eSpark-Backup/fredmeiring-trailersockettester/Hardware-Designing/Deliverables/Renderings/3D_Top.png

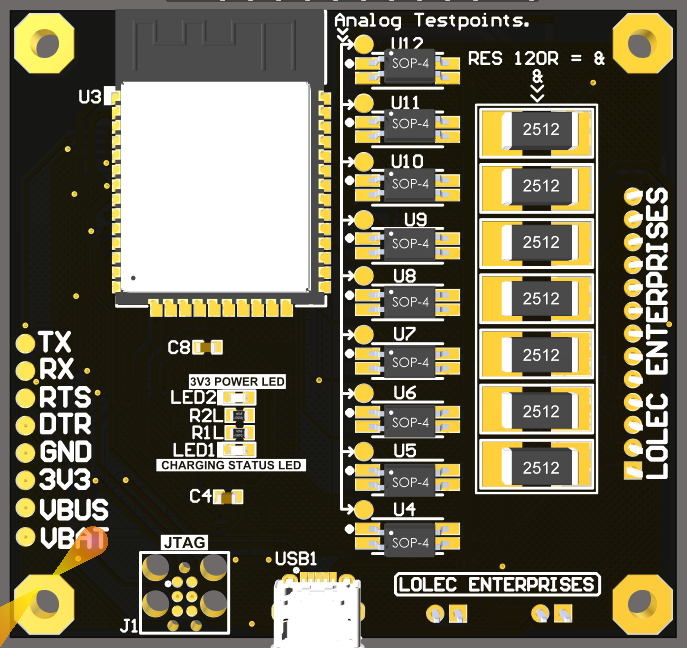
Hardware-Designing/Deliverables/Renderings/3D_Top.png
