eSpark-Backup/fredmeiring-trailersockettester/Hardware-Designing/Deliverables/Renderings/3D_Bottom.png

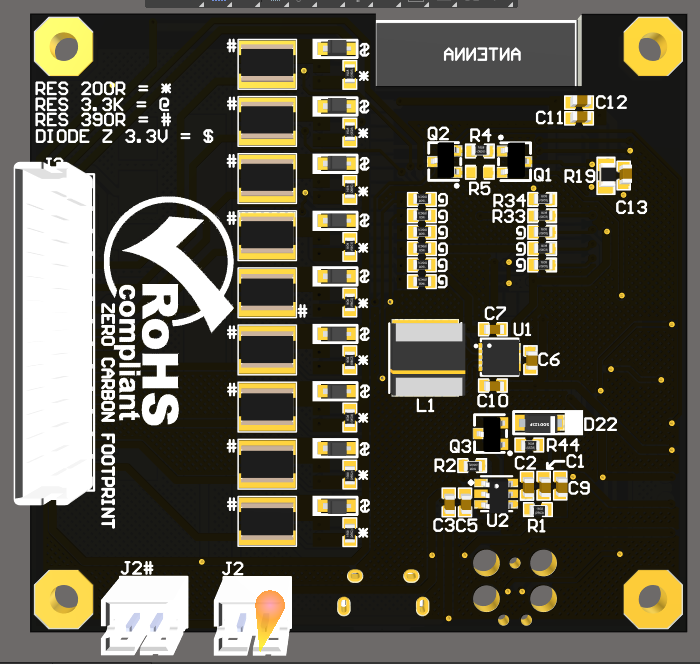
Hardware-Designing/Deliverables/Renderings/3D_Bottom.png
