eSpark-Backup/fredmeiring-trailersockettester/README.md

# FredMeiring-TrailerSocketTester
To design the hardware of a Trailer Socket Tester that can safely read 12V indications from a Trailer and display them in an Android App.
