eSpark-Backup/fredmeiring-trailersockettester/Hardware-Designing/Design-Files/Fred_ New.PcbDoc.htm

Reporting Options

# File in Previous Format

Date | : | 7/24/2023
Time | : | 12:37:49 PM
Filename | : | D:\eSpark-Consultants\FredMeiring-TrailerSocketTester\Hardware-Designing\Design-Files\Fred_ New.PcbDoc

Version | Warning

This file was generated by an earlier version of the software
