eSpark-Backup/fredmeiring-trailersockettester/Hardware-Designing/Deliverables/Renderings/2D_Top.png

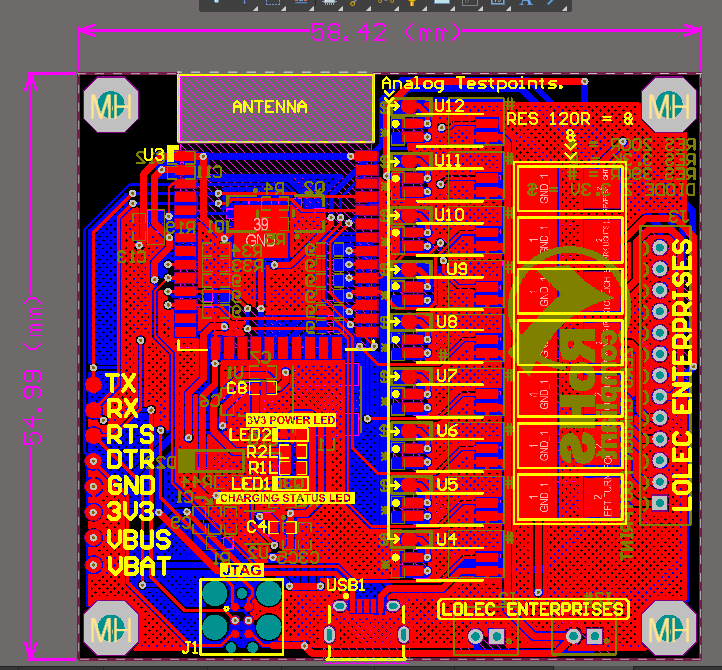
Hardware-Designing/Deliverables/Renderings/2D_Top.png
