eSpark-Backup/fredmeiring-trailersockettester/Hardware-Designing/Deliverables/Renderings/3D_Isometric.png

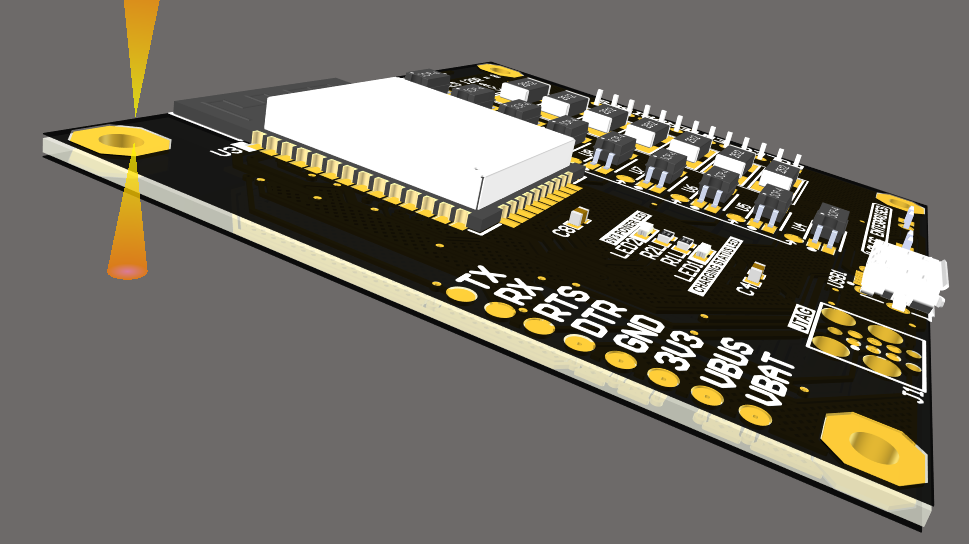
Hardware-Designing/Deliverables/Renderings/3D_Isometric.png
