eSpark-Backup/fredmeiring-trailersockettester/Firmware-Development/Testing-Firmware/Components List/BOM.xlsx

Bill Of Materials
S.No | Materials | Part Number | Package | Value | Description | Reference URL | Quantity | Unit Price | Total Price
1 | ESP32 Module | ESP32-WROOM-32 | SoC IC | - | SMD MODULE, ESP32-D0WDQ6, 32MBIT with onBoard Flash, Crystal Oscillator, Antenna | https://www.digikey.com/product-detail/en/espressif-systems/ESP32-WROOM-32/1904-1010-1-ND/8544305 | 1 | $6.80 | $6.80
2 | LDO Linear Volt Regulator | ADM7172ACPZ-R7 | 8-lead, 3 mm × 3 mm LFCSP package | - | Linear Voltage Regulator IC Positive Adjustable Output 1.2 V - 6.328 V, 2A | https://www.digikey.com/product-detail/en/analog-devices-inc/ADM7172ACPZ-R7/ADM7172ACPZ-R7CT-ND/5004752 | 1 | $4.89 | $4.89
3 | Battery Charging IC | MCP73831T-2ACI/MC | 5-Lead, SOT-23 package | - | Lithium Li-ion/Polymer Battery Charging IC | https://www.digikey.com/product-detail/en/microchip-technology/MCP73831T-2ACI-MC/MCP73831T-2ACI-MCCT-ND/7065590 | 1 | $0.61 | $0.61
4 | Fuel Guage IC | BQ27621YZFR-G1A | 9-pin, 1.62 × 1.58 mm, 0.5 mm pitch YZF package | - | Battery Monitor IC Lithium-Ion 9-DSBGA | https://www.digikey.com/product-detail/en/texas-instruments/BQ27621YZFR-G1A/296-37460-1-ND/4759540 | 1 | $2.27 | $2.27
5 | 6-Axis Accelero/Gyro | ICM-20689 | 24-pin, 4x4x0.9 mm QFN package | - | Accelerometer, Gyroscope, Temperature, 6 Axis Sensor I²C, SPI Output IC | https://www.digikey.com/product-detail/en/tdk-invensense/ICM-20689/1428-1059-1-ND/5872874 | 1 | $6.99 | $6.99
6 | Ceramic CutTape Cap | GCM21BR71H474KA55L | 0805 Package | 0.47uF | 0.47µF ±10% 50V Ceramic Capacitor X7R 0805 (2012 Metric) | https://www.digikey.com/product-detail/en/murata-electronics-north-america/GCM21BR71H474KA55L/490-4788-1-ND/1641707 | 2 | $0.39 | $0.78
7 | Ceramic CutTape Cap | GRM21BR61H475KE51L | 0805 Package | 4.7uF | 4.7µF ±10% 50V Ceramic Capacitor X5R 0805 (2012 Metric) | https://www.digikey.com/product-detail/en/murata-electronics-north-america/GRM21BR61H475KE51L/490-10751-1-ND/5251349 | 4 | $0.40 | $1.60
8 | Ceramic CutTape Cap | GCJ21AR72E102KXJ1D | 0805 Package | 1000pF | 1000pF ±10% 250V Ceramic Capacitor X7R 0805 (2012 Metric) | https://www.digikey.com/product-detail/en/murata-electronics-north-america/GCJ21AR72E102KXJ1D/490-5589-1-ND/2380343 | 1 | $0.28 | $0.28
9 | Ceramic CutTape Cap | GCM21BR71H104KA37K | 0805 Package | 0.1uF | 0.1µF ±10% 50V Ceramic Capacitor X7R 0805 (2012 Metric) | https://www.digikey.com/product-detail/en/murata-electronics-north-america/GCM21BR71H104KA37K/490-8049-1-ND/4380334 | 1 | $0.23 | $0.23
10 | Ceramic CutTape Cap | GCM219R71C105KA37D | 0805 Package | 1uF | 1µF ±10% 16V Ceramic Capacitor X7R 0805 (2012 Metric) | https://www.digikey.com/product-detail/en/murata-electronics-north-america/GCM219R71C105KA37D/490-8043-1-ND/4380328 | 1 | $0.27 | $0.27
11 |  |  |  |  |  |  |  |  | $0.00
12 |  |  |  |  |  |  |  |  | $0.00
13 |  |  |  |  |  |  |  |  | $0.00
14 |  |  |  |  |  |  |  |  | $0.00
15 |  |  |  |  |  |  |  |  | $0.00
16 |  |  |  |  |  |  |  |  | $0.00
17 |  |  |  |  |  |  |  |  | $0.00
