eSpark-Backup/fredmeiring-trailersockettester/Firmware-Development/Testing-Firmware/Components List/Component_List.xlsx

Power Section
S.No | Item Name | Description | Reference Link | Price
1 | ADM7172 | LDO Regulator | www.analog.com/media/en/technical-documentation/data-sheets/adm7172.pdf | -
2 | BQ27621 | Fuel Guage IC | www.ti.com/lit/ds/symlink/bq27621-g1.pdf | -
3 | MCP73831 | Battery Charging IC | https://www.microchip.com/mcp73831 | -
4
5
Controlling Section
S.No | Item Name | Description | Reference Link | Price
1 | ESP32 Module | Main Controller | https://www.espressif.com/zh-hans/products/hardware/esp-wroom-32/overview | -
2
Peripherals (Buttons, Sensors etc)
S.No | Item Name | Description | Reference Link | Price
1 | ICM20689 | 6-Axis Acc/Gyro | https://www.invensense.com/download-pdf/icm-20689-datasheet/ | -
2 | Tactile Switch | 8mm Soft Tactile Buttons | https://www.adafruit.com/product/3101 | -
3 | B3F-1000 | 12mm Hard Tactile Buttons | https://www.adafruit.com/product/367 | -
4
