eSpark-Backup/fredmeiring-trailersockettester/Hardware-Designing/Deliverables/BOM/BOM-FRED_MIERING - DIGIKEY.xlsx

Bill Of Material (BOM) for FRED MEIRING
S. No. | CommentType | Description | Designator | Footprint (Package) | Manufacturer Part Number | Manufacturer | Value | Quantity | Total Quantity | Link | Unit Price | Total Price | Remarks
1 | Capacitor | Capacitor Ceramic 0.1UF 50V Y5V 0603 | C1, C4, C5, C6, C8, C10, C11, C12, C13 | 0603 (1608 Metric) | CC0603ZRY5V9BB104 | Yageo | 0.1uF | 9 | 47 | Digikey (https://www.digikey.com/product-detail/en/avx-corporation/0402ZD104KAT2A/478-1129-1-ND/564161) | $0.10 | $4.70
2 |  | Capacitor Ceramic 1UF 50V X7R 0603 | C9 | 0603 (1608 Metric) | UMK107AB7105KA-T | Taiyo Yuden | 1uF | 1 | 7 | Digikey (https://www.digikey.com/product-detail/en/taiyo-yuden/UMK107AB7105KA-T/587-3247-1-ND/3660107) | $0.25 | $1.75
3 |  | Capacitor Ceramic 4.7UF 25V X5R 0603 | C2 | 0603 (1608 Metric) | GRM188R61E475KE11D | Murata | 4.7uF | 1 | 7 | Digikey (https://www.digikey.com/products/en/capacitors/ceramic-capacitors/60?k=GRM188R61E475KE11D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) | $0.41 | $2.87
4 |  | Capacitor Ceramic 10UF 25V X5R 0603 | C3, C7 | 0603 (1608 Metric) | C1608X5R1E106M080AC | TDK | 10uF | 2 | 12 | Digikey (https://www.digikey.com/products/en/capacitors/ceramic-capacitors/60?k=C1608X5R1E106M080AC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) | $0.84 | $10.08
5 | Transistor | Transistor NPN 40V 0.6A SMD SOT23-3 | Q1, Q2 | SOT23-3 | MMBT2222A-7-F | Diodes Incorporated | --- | 2 | 12 | Digikey (https://www.digikey.com/products/en/discrete-semiconductor-products/transistors-bipolar-bjt-single/276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) | $0.13 | $1.56
6 |  | MOSFET P-Channel 24V SOT23 | Q3 | SOT23-3 | DMP2045U-7 | Diodes Incorporated | --- | 1 | 6 | Digikey (https://www.digikey.com/products/en/discrete-semiconductor-products/transistors-fets-mosfets-single/278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) | $0.43 | $2.58
7 | Diode | Diode Schottky 20V 1A SOD123FL | D22 | SOD-123FL | MBR120VLSFT3G | ON Semiconductor | ---- | 1 | 6 | Digikey (https://www.digikey.com/products/en/discrete-semiconductor-products/diodes-rectifiers-single/280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) | $0.39 | $2.34
8 |  | Diode Zener 3.3V 200MW SOD323F | D1, D2, D3, D4, D5, D6, D7, D8, D9 | SOD323F | MM3Z3V3B | ON Semiconductor | --- | 9 | 46 | Digikey (https://www.digikey.com/products/en/discrete-semiconductor-products/diodes-zener-single/287?k=MM3Z3V3B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) | $0.20 | $9.20
9 |  | LED Blue Clear Chip SMD | LED1, LED2 | 0603 (1608 Metric) | APT1608QBC/D | Kingbright | --- | 2 | 11 | Digikey (https://www.digikey.com/products/en/optoelectronics/led-indication-discrete/105?k=APT1608QBC%2FD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) | $0.44 | $4.84
10 | Inductor | Fixed Inductor 1.5UH 4.2A 20.8 MOHM | L1 | Custom(SMD) | NR6028T1R5N | Taiyo Yuden | --- | 1 | 6 | Digikey (https://www.digikey.com/products/en/inductors-coils-chokes/fixed-inductors/71?k=NR6028T1R5N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) | $0.41 | $2.46
11 | Resistor | Resistor SMD 3.3K OHM 1% 1/10W 0603 | R3, R9, R10, R11, R12, R14, R15, R16, R17 | 0603 (1608 Metric) | RC0603FR-073K3L | Yageo | 3.3K | 9 | 47 | Digikey (https://www.digikey.com/products/en/resistors/chip-resistor-surface-mount/52?k=RC0603FR-073K3L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) | $0.10 | $4.70
12 |  | Resistor SMD 10K OHM 0.1% 1/8W 0805 | R19 | 0805 (2012 Metric) | RT0805BRB0710KL | Yageo | 10K | 1 | 7 | Digikey (https://www.digikey.com/products/en/resistors/chip-resistor-surface-mount/52?k=RT0805BRB0710KL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) | $0.70 | $4.90
13 |  | Resistor SMD 10K OHM 1% 1/10W 0603 | R2, R4, R5 | 0603 (1608 Metric) | RC0603FR-0710KL | Yageo | 10K | 3 | 17 | Digikey (https://www.digikey.com/products/en/resistors/chip-resistor-surface-mount/52?k=RC0603FR-0710KL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) | $0.10 | $1.70
14 |  | Resistor SMD 100K OHM 0.1% 1/10W 0603 | R44 | 0603 (1608 Metric) | RT0603BRD07100KL | Yageo | 100K | 1 | 7 | Digikey (https://www.digikey.com/products/en/resistors/chip-resistor-surface-mount/52?k=RT0603BRD07100KL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) | $0.38 | $2.66
15 |  | Resistor SMD 120 OHM 5% 3W 2512 | R35, R36, R37, R38, R39, R40, R41 | 2512 (6432 Metric) | 3522120RJT | TE Connectivity Passive Product | 120R | 7 | 37 | Digikey (https://www.digikey.com/product-detail/en/te-connectivity-passive-product/3522120RJT/A121132CT-ND/5245189) | $0.65 | $24.05
16 |  | Resistor SMD 133K OHM 1% 1/10W 0603 | R33 | 0603 (1608 Metric) | RC0603FR-07133KL | Yageo | 133K | 1 | 7 | Digikey (https://www.digikey.com/products/en/resistors/chip-resistor-surface-mount/52?k=RC0603FR-07133KL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) | $0.10 | $0.70
17 |  | Resistor SMD 200 OHM 0.5% 1/10W 0603 | R20, R21, R23, R24, R25, R26, R28, R29, R30 | 0603 (1608 Metric) | RT0603DRD07200RL | Yageo | 200R | 9 | 47 | Digikey (https://www.digikey.com/products/en/resistors/chip-resistor-surface-mount/52?k=RT0603DRD07200RL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) | $0.20 | $9.40
18 |  | Resistor SMD 330 OHM 1% 1/10W 0603 | R1L, R2L | 0603 (1608 Metric) | RC0603FR-07330RL | Yageo | 330R | 2 | 12 | Digikey (https://www.digikey.com/products/en/resistors/chip-resistor-surface-mount/52?k=RC0603FR-07330RL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) | $0.10 | $1.20
19 |  | Resistor SMD 390 OHM 0.5% 1W 1206 | R6, R7, R8, R13, R18, R22, R27, R31, R32 | 1206 (3216 Metric) | HRG3216P-3900-D-T1 | Susumu | 390R | 9 | 47 | Digikey (https://www.digikey.com/products/en/resistors/chip-resistor-surface-mount/52?k=HRG3216P-3900-D-T1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) | $0.92 | $43.24
20 |  | RES SMD 665 OHM 1% 1/10W 0603 | R1 | 0603 (1608 Metric) | RC0603FR-07665RL | Yageo | 665R | 1 | 7 | Digikey (https://www.digikey.com/product-detail/en/yageo/RC0603FR-07665RL/311-665HRCT-ND/730296) | $0.10 | $0.70
21 |  | Thin Film Resistors - SMD 1/10W 49.3K Ohms .5% | R34 | 0603 (1608 Metric) | RT0603DRE0749K3L | Yageo | 49.3K | 1 | 7 | Mouser (https://eu.mouser.com/ProductDetail/Yageo/RT0603DRE0749K3L?qs=bQfrgN9vNvyV7KQpBB9OQw%3D%3D) | $0.16 | $1.12
22 | Connector | ~~Socket~~ | ~~T1, T2, T3, T4, T5, T6, T7, T8, T9, T10, T11, T12, T13, T14, T15, T16, T17~~ | ~~Socket~~ | --- | --- | --- | ~~17~~ | ~~85~~ | --- |  |  | ~~Do Not Mount~~
23 |  | ~~Cable Adapter 6 Position~~ | ~~J1~~ | ~~Custom(SMD)~~ | ~~TC2030-IDC~~ | ~~Tag-Connect~~ | --- | ~~1~~ | ~~5~~ | --- |  |  | ~~Do Not Mount~~
24 |  | CONN HOUSING PH 2POS 2MM WHITE | --- | --- | PHR-2 | JST Sales America Inc | --- | 2 | 11 | Digikey (https://www.digikey.com/product-detail/en/jst-sales-america-inc/PHR-2/455-1165-ND/608607) | $0.10 | $1.10
25 |  | CONN HEADER VERT 2POS 2MM | J2,J2# | Through Hole(2.0mm) | B2B-PH-K-S(LF)(SN) | JST Sales America Inc. | --- | 2 | 11 | Digikey (https://www.digikey.com/products/en?keywords=B2B-PH-K-S(LF)(SN)) | $0.17 | $1.87
26 |  | CONN HOUSING PH 13POS 2MM WHITE | --- | --- | PHR-13 | JST Sales America Inc. | --- | 2 | 11 | Digikey (https://www.digikey.com/product-detail/en/jst-sales-america-inc/PHR-13/455-1155-ND/608597) | $0.26 | $2.86
27 |  | CONN HEADER VERT 13POS 2MM | J3 | Through Hole(2.00mm) | B13B-PH-K-S(LF)(SN) | JST Sales America Inc. | --- | 1 | 6 | Digikey (https://www.digikey.com/products/en?keywords=B13B-PH-K-S(LF)(SN)) | $0.59 | $3.54
28 |  | Connector USB Micro-B Receptacle SMD R/A | USB1 | USB_Micro_B(SMD) | 10118192-0001LF | AMPHENOL ICC (FCI) | --- | 1 | 6 | Digikey (https://www.digikey.com/products/en/connectors-interconnects/usb-dvi-hdmi-connectors/312?k=10118192-0001LF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) | $0.43 | $2.58
29 | IC | Converter DC-DC 1.8V to 5.5V Non-Inv/Inv/Step Up/Step Down Single-Out 3.3V 0.8A 10-Pin 10-SON | U1 | 10-SON | TPS63031DSKR | Texas Instruments | --- | 1 | 6 | Digikey (https://www.digikey.com/products/en/integrated-circuits-ics/pmic-voltage-regulators-dc-dc-switching-regulators/739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) | $1.87 | $11.22
30 |  | IC BAT CHG LI-ION 1 CELL SOT23-6 | U2 | SOT-23-6 | BQ21040DBVR | Texas Instruments | --- | 1 | 6 | Digikey (https://www.digikey.com/products/en/integrated-circuits-ics/pmic-battery-chargers/781?k=BQ21040DBVR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) | $1.19 | $7.14
31 |  | SMD MODULE, ESP32-D0WDQ6, 32MBIT | U3 | Custom(SMD) | ESP32-WROOM-32 | Espressif Systems | --- | 1 | 6 | Digikey (https://www.digikey.com/product-detail/en/espressif-systems/ESP32-WROOM-32/1904-1010-1-ND/8544305) | $3.80 | $22.80
32 |  | Optoisolator Transistor SMD | U4, U5, U6, U7, U8, U9, U10, U11, U12 | 4-SOIC | PC3H712NIP1H | SHARP/Socle Technology | --- | 9 | 47 | Digikey (https://www.digikey.com/products/en/isolators/optoisolators-transistor-photovoltaic-output/903?k=PC3H712NIP1H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) | $0.84 | $39.48
