eSpark-Backup/fredmeiring-trailersockettester/Hardware-Designing/Deliverables/BOM/BOM-FRED_MIERING - LCSC.xlsx

Bill Of Material (BOM) for FRED MEIRING
S. No. | CommentType | Description | Designator | Footprint (Package) | Manufacturer Part Number | Manufacturer | Value | Quantity | Total Quantity | LCSC Quantity | Link | Unit Price (LCSC) | Total Price (LCSC) | Unit Price (Digikey) | Total Price (Digikey) | Remarks
1 | Capacitor | Capacitor Ceramic 100nF ±20% 50V Y5V 0603 | C1, C4, C5, C6, C8, C10, C11, C12, C13 | 0603 (1608 Metric) | 0603F104M500NT | FH(Guangdong Fenghua Advanced Tech) | 0.1uF | 9 | 47 | 50 | LCSC (https://lcsc.com/product-detail/Multilayer-Ceramic-Capacitors-MLCC-SMD-SMT_FH-Guangdong-Fenghua-Advanced-Tech-0603F104M500NT_C42998.html) | $0.012 | $0.58 | $0.10 | $4.70 | Approved By Faizi - MOQ 50
2 |  | Capacitor Ceramic 1uF ±10% 50V X7R 0603 | C9 | 0603 (1608 Metric) | UMK107AB7105KA-T | Taiyo Yuden | 1uF | 1 | 7 | 20 | LCSC (https://lcsc.com/product-detail/Multilayer-Ceramic-Capacitors-MLCC-SMD-SMT_TAIYO-YUDEN_UMK107AB7105KA-T_1uF-105-10-50V_C105174.html) | $0.022 | $0.44 | $0.25 | $1.75 | Approved By Faizi - MOQ 20
3 |  | Capacitor Ceramic 4.7uF ±10% 25V X5R 0603 | C2 | 0603 (1608 Metric) | GRM188R61E475KE11D | Murata Electronics | 4.7uF | 1 | 7 | 10 | LCSC (https://lcsc.com/product-detail/Multilayer-Ceramic-Capacitors-MLCC-SMD-SMT_Murata-Electronics-GRM188R61E475KE11D_C90057.html) | $0.074 | $0.74 | $0.41 | $2.87 | Approved By Faizi - MOQ 10
4 |  | Capacitor Ceramic 10uF ±20% 25V X5R 0603 | C3, C7 | 0603 (1608 Metric) | C1608X5R1E106MT000E | TDK | 10uF | 2 | 12 | 20 | LCSC (https://lcsc.com/product-detail/Multilayer-Ceramic-Capacitors-MLCC-SMD-SMT_TDK-C1608X5R1E106MT000E_C76614.html) | $0.058 | $1.15 | $0.84 | $10.08 | Approved By Faizi - MOQ 20
5 | Transistor | NPN 600mA 40V 310mW SOT-23 | Q1, Q2 | SOT23-3 | MMBT2222A-7-F | Diodes Incorporated | --- | 2 | 12 | 20 | LCSC (https://lcsc.com/product-detail/Transistors-NPN-PNP_DIODES_MMBT2222A-7-F_MMBT2222A-7-F_C94515.html) | $0.016 | $0.32 | $0.13 | $1.56 | Approved By Faizi - MOQ 20
6 |  | MOSFET P-Channel 24V SOT23 | Q3 | SOT23-3 | DMP2045U-7 | Diodes Incorporated | --- | 1 | 6 | 10 | LCSC (https://lcsc.com/product-detail/MOSFET_Diodes-Incorporated-DMP2045U-7_C459541.html) | $0.105 | $1.05 | $0.43 | $2.58 | Approved By Faizi - MOQ 10
7 | Diode | Diode Schottky 20V 1A SOD123FL | D22 | SOD-123FL | MBR120ESFT1G | ON Semiconductor | ---- | 1 | 6 | 10 | LCSC (https://lcsc.com/product-detail/Schottky-Barrier-Diodes-SBD_ON-Semiconductor-ON-Semiconductor-MBR120ESFT1G_C236132.html) | $0.118 | $1.18 | $0.39 | $2.34 | Added By Faizi - MOQ 10
8 |  | Diode Zener 3.3V 200MW SOD323F | D1, D2, D3, D4, D5, D6, D7, D8, D9 | SOD323F | MM3Z3V3CW | Tak Cheong | --- | 9 | 46 | 50 | LCSC (https://lcsc.com/product-detail/Others_Tak-Cheong-MM3Z3V3CW_C248774.html) | $0.015 | $0.76 | $0.20 | $9.20 | Approved By Faizi - MOQ 50
9 |  | LED Blue Clear Chip SMD | LED1, LED2 | 0603 (1608 Metric) | 19-21/BHC-AN1P2/3T | Everlight Elec | --- | 2 | 11 | 20 | LCSC (https://lcsc.com/product-detail/Others_Everlight-Elec-19-21-BHC-AN1P2-3T_C282129.html) | $0.041 | $0.82 | $0.44 | $4.84 | Added By Faizi - MOQ 20
10 | Inductor | Fixed Inductor 1.5uH ±30% 3.7A 21mΩ | L1 | Custom(SMD) | YNR6028-1R5N | YJYCOIN | --- | 1 | 6 | 10 | LCSC (https://lcsc.com/product-detail/Power-Inductors_YJYCOIN-YNR6028-1R5N_C341052.html) | $0.068 | $0.68 | $0.41 | $2.46 | Approved By Electron - MOQ 5
11 | Resistor | Resistor SMD 3.3K ±1% 1/10W ±100ppm/℃ 0603 | R3, R9, R10, R11, R12, R14, R15, R16, R17 | 0603 (1608 Metric) | RC0603FR-073K3L | Yageo | 3.3K | 9 | 47 | 100 | LCSC (https://lcsc.com/product-detail/Chip-Resistor-Surface-Mount_3-3KR-3301-1_C108078.html) | $0.003 | $0.27 | $0.10 | $4.70 | Approved By Faizi - MOQ 100
12 |  | Resistor SMD 10K ±0.1% 1/8W 0805 | R19 | 0805 (2012 Metric) | RT0805BRD0710KL | Yageo | 10K | 1 | 7 | 10 | LCSC (https://lcsc.com/product-detail/High-Precision-Low-TCR-SMD-Resistors_10KR-1002-0-1_C110775.html) | $0.040 | $0.40 | $0.70 | $4.90 | Approved By Faizi - MOQ 10 | These two resistors are off same value(10K) but different in package (1 is of 0805 & 3 is of 0603). But these Ambiguity still not solved in the design.
13 |  | Resistor SMD 10K ±1% 1/10W ±100ppm/℃ 0603 | R2, R4, R5 | 0603 (1608 Metric) | AC0603FR-0710KL | Yageo | 10K | 3 | 17 | 50 | LCSC (https://lcsc.com/product-detail/Chip-Resistor-Surface-Mount_10KR-1002-1_C116677.html) | $0.003 | $0.17 | $0.10 | $1.70 | Changed By Faizi - MOQ
14 |  | Resistor SMD 100K ±1% 1/10W ±100ppm/℃ 0603 | R44 | 0603 (1608 Metric) | CR0603FA1003G | LIZ Elec | 100K | 1 | 7 | 50 | LCSC (https://lcsc.com/product-detail/Chip-Resistor-Surface-Mount_100KR-1003-1_C100703.html) | $0.003 | $0.165 | $0.38 | $2.66 | Approved By Faizi - MOQ 50
15 |  | Resistor SMD 120 ±5% 1W 2512 | R35, R36, R37, R38, R39, R40, R41 | 2512 (6432 Metric) | RMC25121205%N | TyoHM | 120R | 7 | 37 | 40 | LCSC (https://lcsc.com/product-detail/Chip-Resistor-Surface-Mount_TyoHM-RMC25121205-N_C269347.html) | $0.021 | $0.846 | $0.65 | $24.05 | Need to change Watt in production
16 |  | Resistor SMD 130K ±1% 1/10W ±100ppm/℃ 0603 | R33 | 0603 (1608 Metric) | RC0603FR-07130KL | Yageo | 130K | 1 | 7 | 100 | LCSC (https://lcsc.com/product-detail/Chip-Resistor-Surface-Mount_RC0603FR-07130KL_C163432.html) | $0.003 | $0.277 | $0.100 | $0.70 | Value of resistance changed due to non-availability
17 |  | Resistor SMD 200 ±1% 1/10W ±100ppm/℃ 0603 | R20, R21, R23, R24, R25, R26, R28, R29, R30 | 0603 (1608 Metric) | RTT032000FTP | RALEC | 200R | 9 | 47 | 100 | LCSC (https://lcsc.com/product-detail/Chip-Resistor-Surface-Mount_200R-2000-1_C103389.html) | $0.002 | $0.220 | $0.200 | $9.40 | Changed By Faizi - MOQ 100
18 |  | Resistor SMD 330 ±0.5% 1/10W ±50ppm/°C 0603 | R1L, R2L | 0603 (1608 Metric) | ERJ3RBD331V | PANASONIC | 330R | 2 | 12 | 20 | LCSC (https://lcsc.com/product-detail/Chip-Resistor-Surface-Mount_PANASONIC-ERJ3RBD331V_C416701.html) | $0.016 | $0.312 | $0.10 | $1.20 | Approved By Faizi - MOQ 20
19 |  | Resistor SMD 390 ±1% 1W ±100ppm/℃ 1218 | R6, R7, R8, R13, R18, R22, R27, R31, R32 | 1218 (3245 Metric) | CRW1218F390RE04Z | Ever Ohms Tech | 390R | 9 | 47 | 60 | LCSC (https://lcsc.com/product-detail/Chip-Resistor-Surface-Mount_Ever-Ohms-Tech-CR1218F390RE04_C175553.html) | $0.017 | $1.007 | $0.920 | $43.240 | Added By Faizi - MOQ 20
20 |  | 665Ω ±1% 0.1W ±100ppm/℃ 0603 Chip Resistor - Surface Mount RoHS | R1 | 0603 (1608 Metric) | 0603WAF6650T5E | UNI-ROYAL(Uniroyal Elec) | 665R | 1 | 7 | 100 | LCSC (https://lcsc.com/product-detail/Chip-Resistor-Surface-Mount_UNI-ROYAL-Uniroyal-Elec-0603WAF6650T5E_C23096.html) | $0.001 | $0.124 | $0.100 | $0.70 | Changed By Faizi - MOQ 50
21 |  | Thin Film Resistors - 49.9K ±1% 1/10W ±100ppm/℃ 0603 | R34 | 0603 (1608 Metric) | RC0603FR-0749K9L | Yageo | 49.9K | 1 | 7 | 100 | LCSC (https://lcsc.com/product-detail/Chip-Resistor-Surface-Mount_49-9KR-4992-1_C114624.html) | $0.003 | $0.31 | $0.160 | $1.12 | Value of resistance changed due to non-availability
22 | Connector | ~~Socket~~ | ~~T1, T2, T3, T4, T5, T6, T7, T8, T9, T10, T11, T12, T13, T14, T15, T16, T17~~ | ~~Socket~~ | --- | --- | --- | ~~17~~ | ~~85~~ |  |  |  |  |  |  | ~~Do Not Mount~~
23 |  | ~~Cable Adapter 6 Position~~ | ~~J1~~ | ~~Custom(SMD)~~ | ~~TC2030-IDC~~ | ~~Tag-Connect~~ | --- | ~~1~~ | ~~5~~ |  |  |  |  |  |  | ~~Do Not Mount~~
24 |  | CONN HOUSING PH 2POS 2MM WHITE | --- | --- | PHR-2 | JST Sales America Inc | --- | 2 | 11 | 50 | LCSC (https://lcsc.com/product-detail/Rectangular-Connectors-Housings_JST-Sales-America_PHR-2_JST-Sales-America-PHR-2_C157955.html) | $0.009 | $0.43 | $0.10 | $1.10 | Approved By Faizi - MOQ 50
25 |  | CONN HEADER VERT 2POS 2MM | J2,J2# | Through Hole(2.0mm) | B2B-PH-K-S(LF)(SN) | JST Sales America Inc. | --- | 2 | 11 | 20 | LCSC (https://lcsc.com/product-detail/Wire-To-Board-Wire-To-Wire-Connector_JST-Sales-America_B2B-PH-K-S-LF-SN_JST-Sales-America-B2B-PH-K-S-LF-SN_C131337.html) | $0.020 | $0.41 | $0.17 | $1.87 | Approved By Faizi - MOQ 20
26 |  | CONN HOUSING PH 13POS 2MM WHITE | --- | --- | PHR-13 | JST Sales America Inc. | --- | 1 | 6 | 10 | LCSC (https://lcsc.com/product-detail/Rectangular-Connectors-Housings_JST-Sales-America_PHR-13_JST-Sales-America-PHR-13_C157959.html) | $0.067 | $0.67 | $0.26 | $1.56 | Approved By Faizi - MOQ 5
27 |  | CONN HEADER VERT 13POS 2MM | J3 | Through Hole(2.00mm) | B13B-PH-K-S(LF)(SN) | JST Sales America Inc. | --- | 1 | 6 | 6 | LCSC (https://lcsc.com/product-detail/Wire-To-Board-Wire-To-Wire-Connector_JST-Sales-America_B13B-PH-K-S-LF-SN_JST-Sales-America-B13B-PH-K-S-LF-SN_C158026.html) | $0.112 | $0.67 | $0.59 | $3.54 | Approved By Faizi - MOQ 1
28 |  | Connector USB Micro-B Receptacle SMD R/A | USB1 | USB_Micro_B(SMD) | C10418 | Jing Extension of the Electronic Co. | --- | 1 | 6 | 6 | LCSC (https://lcsc.com/product-detail/USB-Connectors_Jing-Extension-of-the-Electronic-Co-C10418_C10418.html) | $0.057 | $0.34 | $0.430 | $2.580 | Approed By Faizi - MOQ 5
29 | IC | Converter DC-DC 1.8V to 5.5V Non-Inv/Inv/Step Up/Step Down Single-Out 3.3V 0.8A 10-Pin 10-SON | U1 | 10-SON | TPS63031DSKR | Texas Instruments | --- | 1 | 6 | 6 | LCSC (https://lcsc.com/product-detail/DC-DC-Converters_Texas-Instruments_TPS63031DSKR_Texas-Instruments-Texas-Instruments-TPS63031DSKR_C15516.html) | $1.070 | $6.42 | $1.87 | $11.22 | Approved By Faizi - MOQ 1
30 |  | IC BAT CHG LI-ION 1 CELL SOT23-6 | U2 | SOT-23-6 | BQ21040DBVR | Texas Instruments | --- | 1 | 6 | 6 | LCSC (https://lcsc.com/product-detail/PMIC-Battery-Management_Texas-Instruments_BQ21040DBVR_Texas-Instruments-Texas-Instruments-BQ21040DBVR_C202311.html) | $0.250 | $1.50 | $1.19 | $7.14 | Approved By Faizi - MOQ 1
31 |  | SMD MODULE, ESP32-D0WDQ6, 32MBIT | U3 | Custom(SMD) | ESP32-WROOM-32 | Espressif Systems | --- | 1 | 6 | 6 | LCSC (https://lcsc.com/product-detail/WIFI-Modules_ESP-WROOM-32_C95209.html) | $2.661 | $15.96 | $3.80 | $22.80 | Added By Faizi - MOQ 11
32 |  | Optoisolator Transistor SMD | U4, U5, U6, U7, U8, U9, U10, U11, U12 | SOP-4 | PS2801C-1-F3-A | RENESAS | --- | 9 | 47 | 50 | LCSC (https://lcsc.com/product-detail/Optocouplers_RENESAS_PS2801C-1-F3-A_RENESAS-PS2801C-1-F3-A_C67112.html) | $0.217 | $10.83 | $0.840 | $39.480 | Approved By Faizi - MOQ 1
 |  |  |  |  |  |  |  | Total Component Cost
 |  |  |  |  |  |  |  | Custom Charges |  |  |  |  | $35
 |  | Notes: |  |  |  |  |  | Shipping Charges |  |  |  |  | $50
 |  | 1- The costing is done for Five (5) boards. All components will be calculated with multiplication factor Five (5). |  |  |  |  |  | Total |  |  |  |  | $85
 |  | 2- Supplier costing and custom charges are added in the final cost.
