eSpark-Backup/fredmeiring-trailersockettester/Hardware-Designing/Deliverables/Renderings/Fred_ New.step

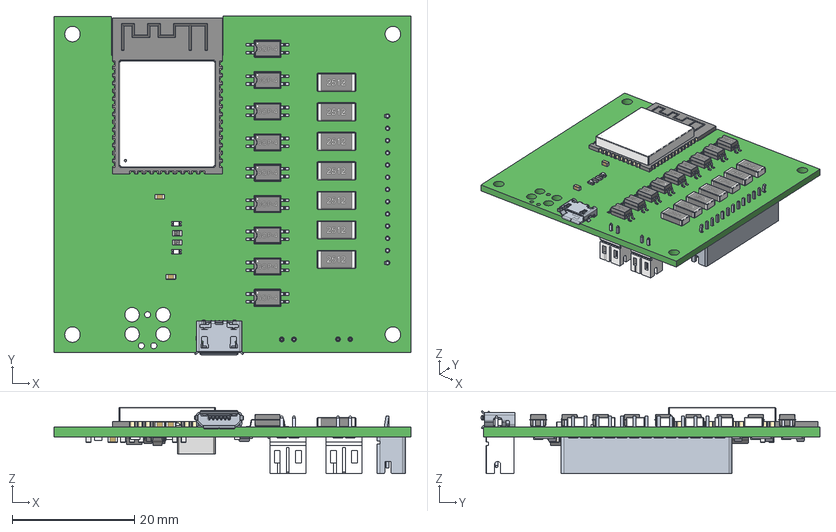
[picture p5: CAD file, 2021-09-08]
Hardware-Designing/Deliverables/Renderings/Fred_ New.step
58.4 x 55.4 x 10.9 mm
Board
User_Library-SMD_Resistors x 9
10118194c
IND_TAIYO_NR6028
c-1-440054-3-f4-3d
B2B-PH-K-S(LF)(SN)--3DModel-STEP-56544 x 2
User_Library-SOD123F
User_Library-CAPC1608X09 x 13
User_Library-CR2012-0805
User_Library-SOD-323F-1 x 9
User_Library-SOD-323F_Extruded8 x 18
User_Library-SOD-323F_Extruded6 x 9
User_Library-SOD-323F_Extruded7 x 9
User_Library-SOD-323F_Extruded9 x 18
User_Library-SOD-323F_Board4 x 18
User_Library-SOD-323F_Extruded11 x 9
User_Library-SOD-323F_Board3 x 18
User_Library-SOD-323F_Extruded10 x 18
User_Library-SOD-323F_Board5 x 9
User_Library-RESC1608X05N x 27
User_Library-My-DFN-10-3x3-0.5_Part_13
User_Library-My-DFN-10-3x3-0.5_Body
User_Library-My-DFN-10-3x3-0.5_14
User_Library-My-DFN-10-3x3-0.5_13
User_Library-My-DFN-10-3x3-0.5_2
User_Library-My-DFN-10-3x3-0.5_1
User_Library-My-DFN-10-3x3-0.5_11
User_Library-My-DFN-10-3x3-0.5_3
User_Library-My-DFN-10-3x3-0.5_12
User_Library-My-DFN-10-3x3-0.5_4
User_Library-My-DFN-10-3x3-0.5_10
User_Library-My-DFN-10-3x3-0.5_5
User_Library-My-DFN-10-3x3-0.5_TP
User_Library-2512_SMD_Resistor x 7
CircuitWorks-SOT-23 x 3
User_Library-SOP-4-1 x 9
User_Library-SOT23-6-2
ESP32-WROOM-32D--3DModel-STEP-56544
User_Library-LED_SMD0603 x 2
