eSpark-Backup/fredmeiring-trailersockettester/Hardware-Designing/Library-Files/Step file/IND_TAIYO_NR6028.step

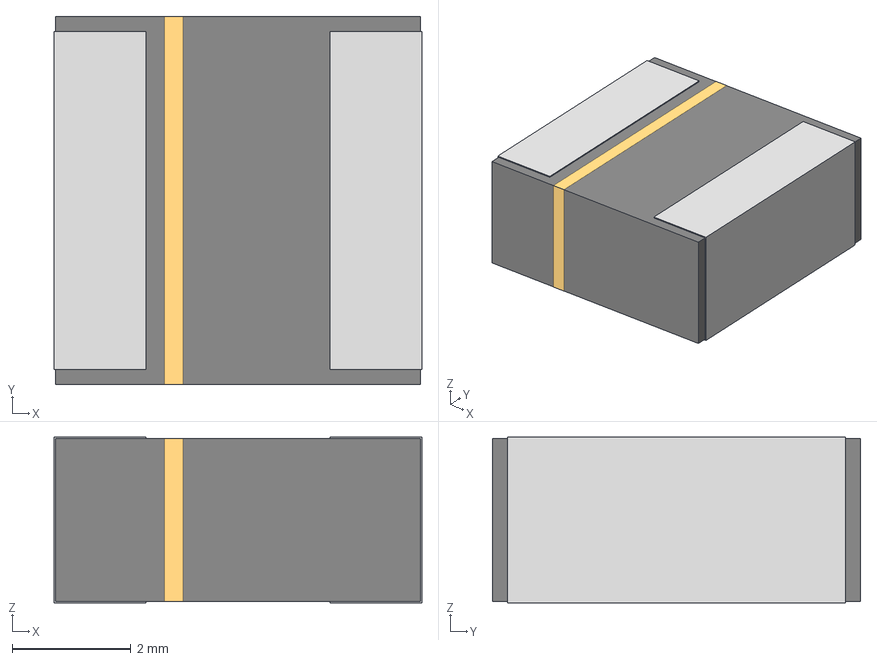
[picture p6: CAD file, 2021-09-08]
Hardware-Designing/Library-Files/Step file/IND_TAIYO_NR6028.step
6.20 x 6.20 x 2.79 mm
