eSpark-Backup/fredmeiring-trailersockettester/Hardware-Designing/Library-Files/Step file/User Library-LED SMD0603.step

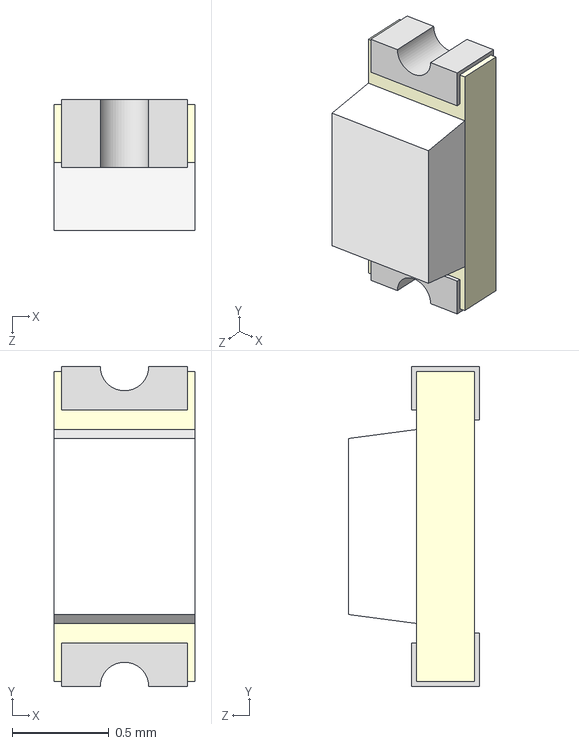
[picture p7: CAD file, 2021-09-08]
Hardware-Designing/Library-Files/Step file/User Library-LED SMD0603.step
0.725 x 1.65 x 0.675 mm
