eSpark-Backup/fredmeiring-trailersockettester/Hardware-Designing/Library-Files/Step file/User Library-SOP254P665X290.step

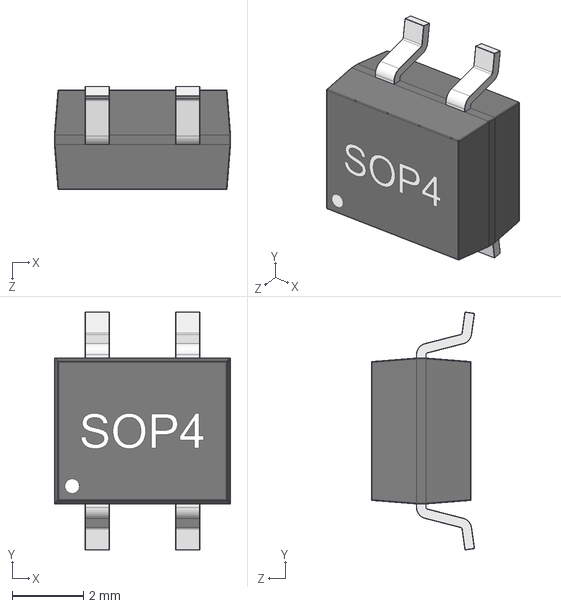
[picture p8: CAD file, 2021-09-08]
Hardware-Designing/Library-Files/Step file/User Library-SOP254P665X290.step
4.95 x 6.69 x 2.90 mm
