eSpark-Backup/fredmeiring-trailersockettester/Hardware-Designing/Library-Files/Step file/User Library-DFN 8.step

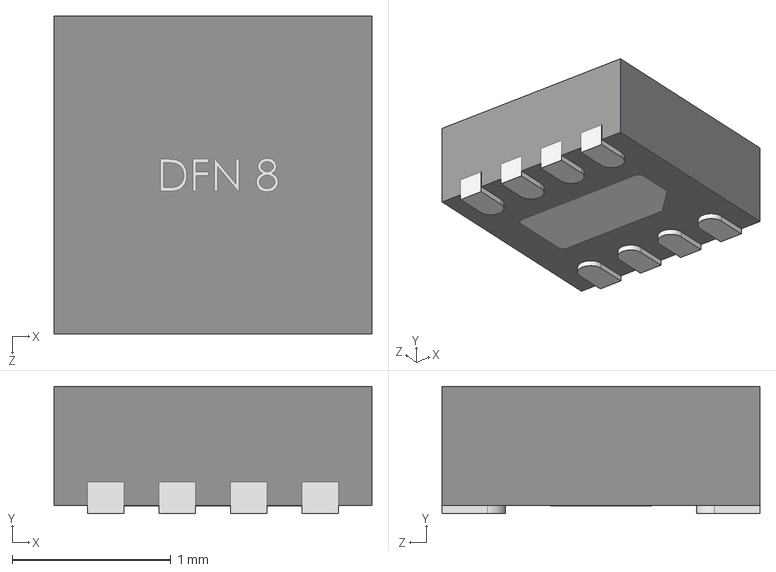
[picture p9: CAD file, 2021-09-08]
Hardware-Designing/Library-Files/Step file/User Library-DFN 8.step
2.00 x 0.801 x 2.00 mm
