eSpark-Backup/fredmeiring-trailersockettester/Hardware-Designing/Library-Files/Step file/con_header_vert_16pos_2mm.stp

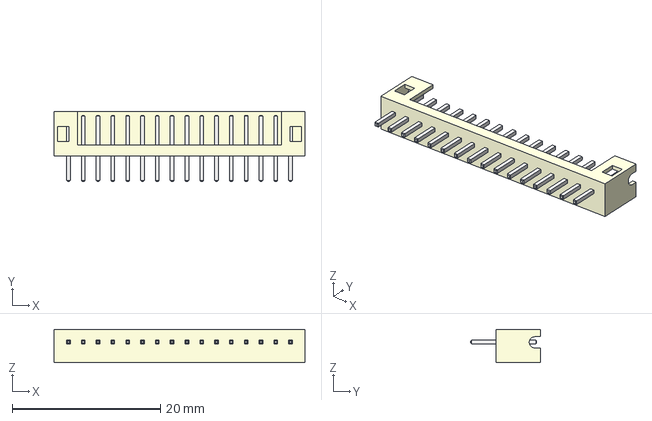
[picture p10: CAD file, 2021-09-08]
Hardware-Designing/Library-Files/Step file/con_header_vert_16pos_2mm.stp
33.9 x 9.40 x 4.50 mm
