eSpark-Backup/fredmeiring-trailersockettester/Hardware-Designing/Library-Files/Step file/User Library-ACPL-217-56DE.step

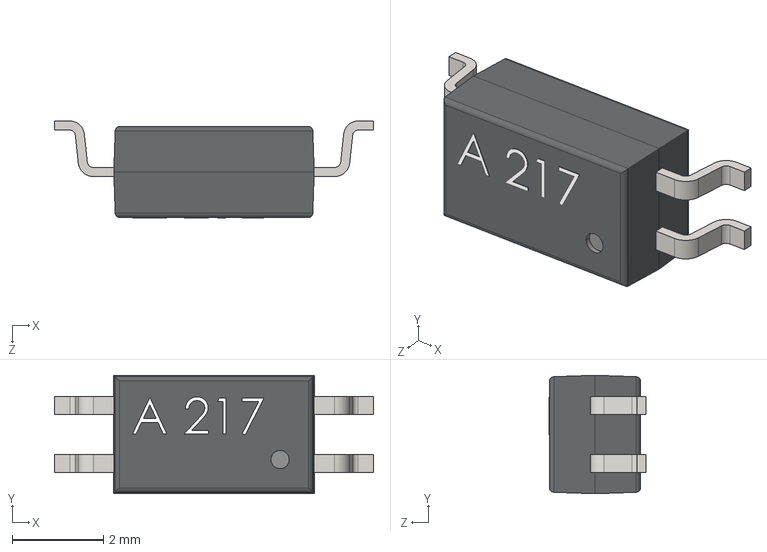
[picture p11: CAD file, 2021-09-08]
Hardware-Designing/Library-Files/Step file/User Library-ACPL-217-56DE.step
7.00 x 2.60 x 2.13 mm
