eSpark-Backup/fredmeiring-trailersockettester/Hardware-Designing/Library-Files/Step file/TS01AQE.stp

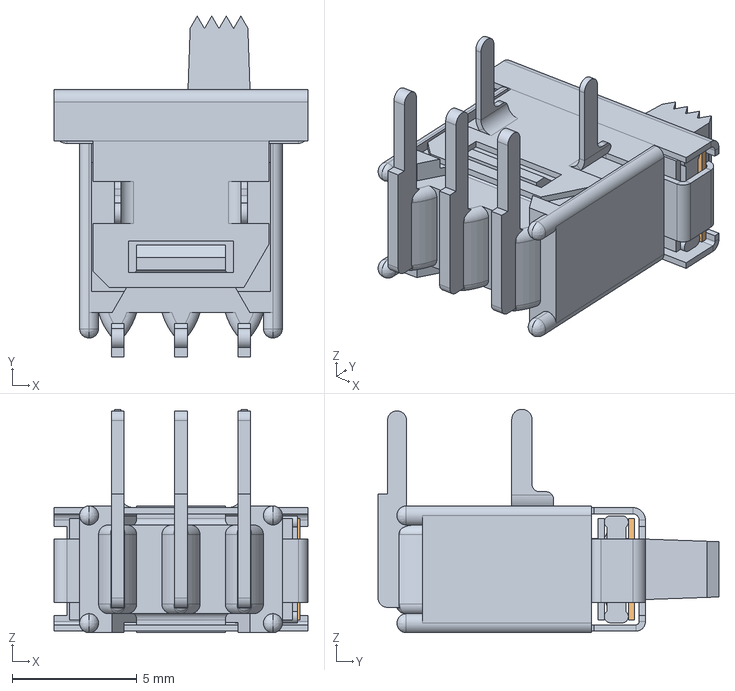
[picture p12: CAD file, 2021-09-08]
Hardware-Designing/Library-Files/Step file/TS01AQE.stp
10.2 x 13.7 x 8.95 mm
