eSpark-Backup/fredmeiring-trailersockettester/Hardware-Designing/Library-Files/Step file/S1AWB.stp

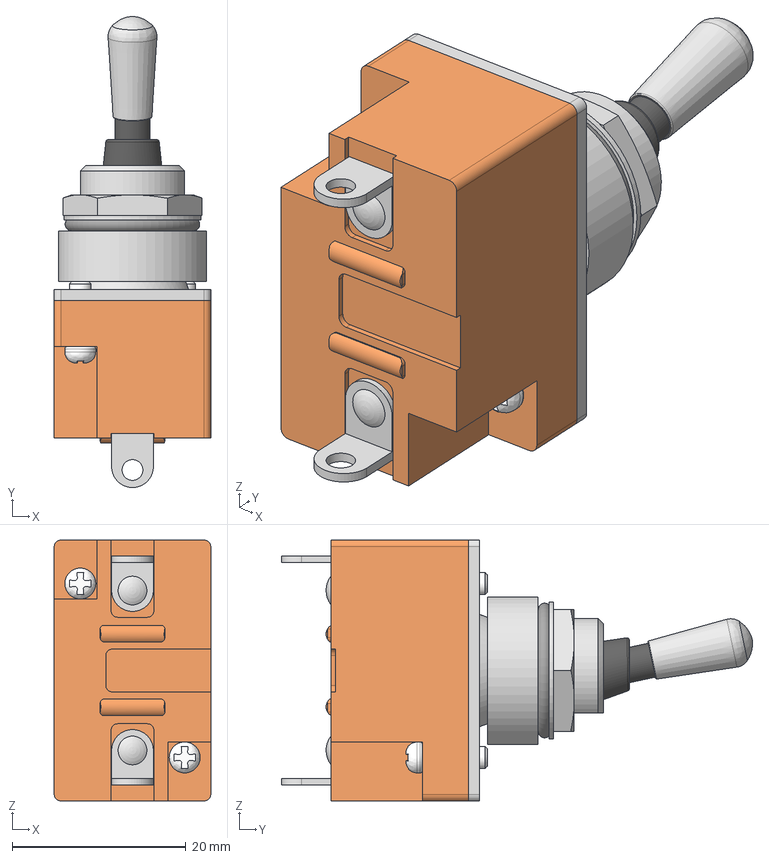
[picture p13: CAD file, 2021-09-08]
Hardware-Designing/Library-Files/Step file/S1AWB.stp
18.0 x 54.2 x 30.0 mm
_SWP_body1-body
_SMC_plate12_plate
_S1AWB_bat
_AT503M
_Lockwasher
_AT537_at537
_1A_gum
_SMC_trmnls1-terminals
_M2.5x7.5 x 2
