eSpark-Backup/fredmeiring-trailersockettester/Hardware-Designing/Library-Files/Step file/G3T12AH.stp

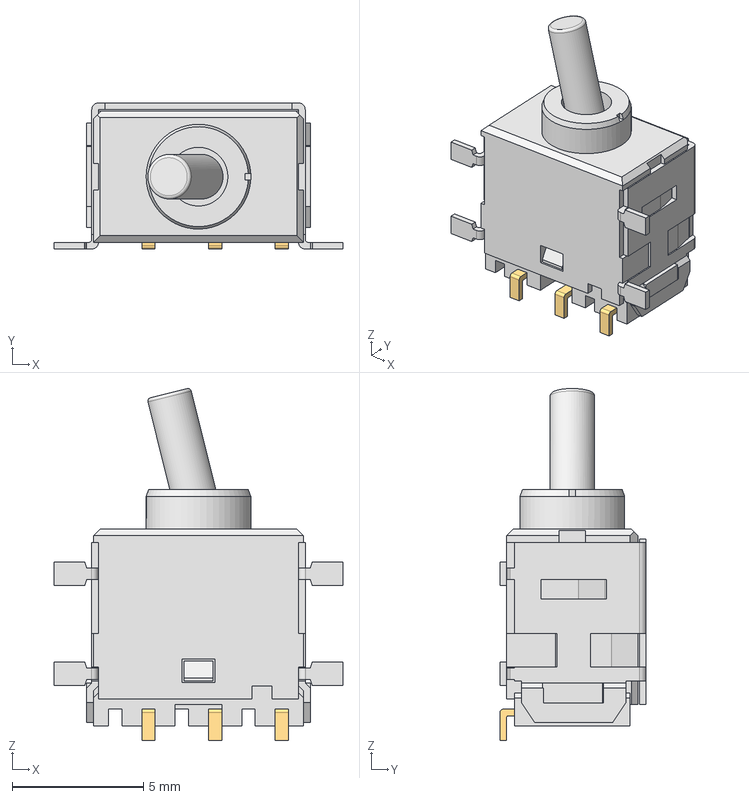
[picture p14: CAD file, 2021-09-08]
Hardware-Designing/Library-Files/Step file/G3T12AH.stp
11.0 x 5.56 x 13.4 mm
_G3B
_G3BA-actuator
_G3BP-h
_G3B1H
