eSpark-Backup/fredmeiring-trailersockettester/Hardware-Designing/Library-Files/Step file/User Library-SOT23-6-2.step

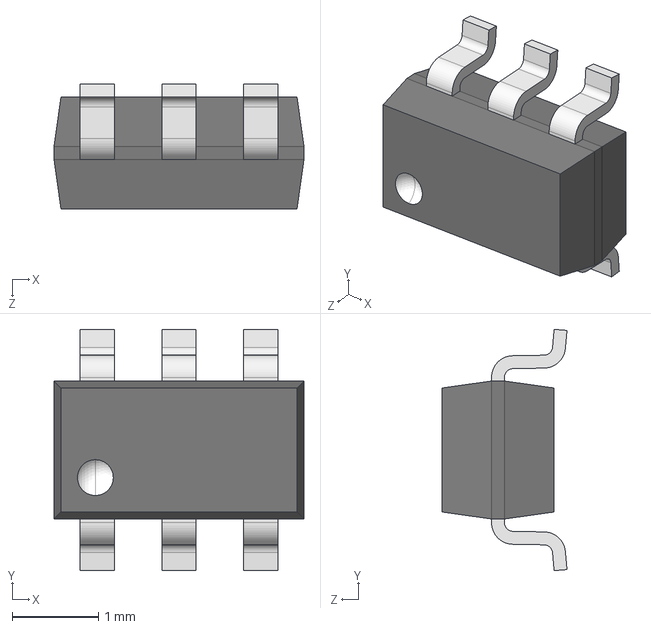
[picture p15: CAD file, 2021-09-08]
Hardware-Designing/Library-Files/Step file/User Library-SOT23-6-2.step
2.90 x 2.80 x 1.45 mm
