eSpark-Backup/fredmeiring-trailersockettester/(list of files, cad)

Other CAD files:
Hardware-Designing/Deliverables/Renderings/Fred_ New.DWG
Hardware-Designing/Deliverables/Renderings/Fred_ New.DXF
