eSpark-Backup/fredmeiring-trailersockettester/Hardware-Designing/Deliverables/Schematics/Schematic PDF.pdf

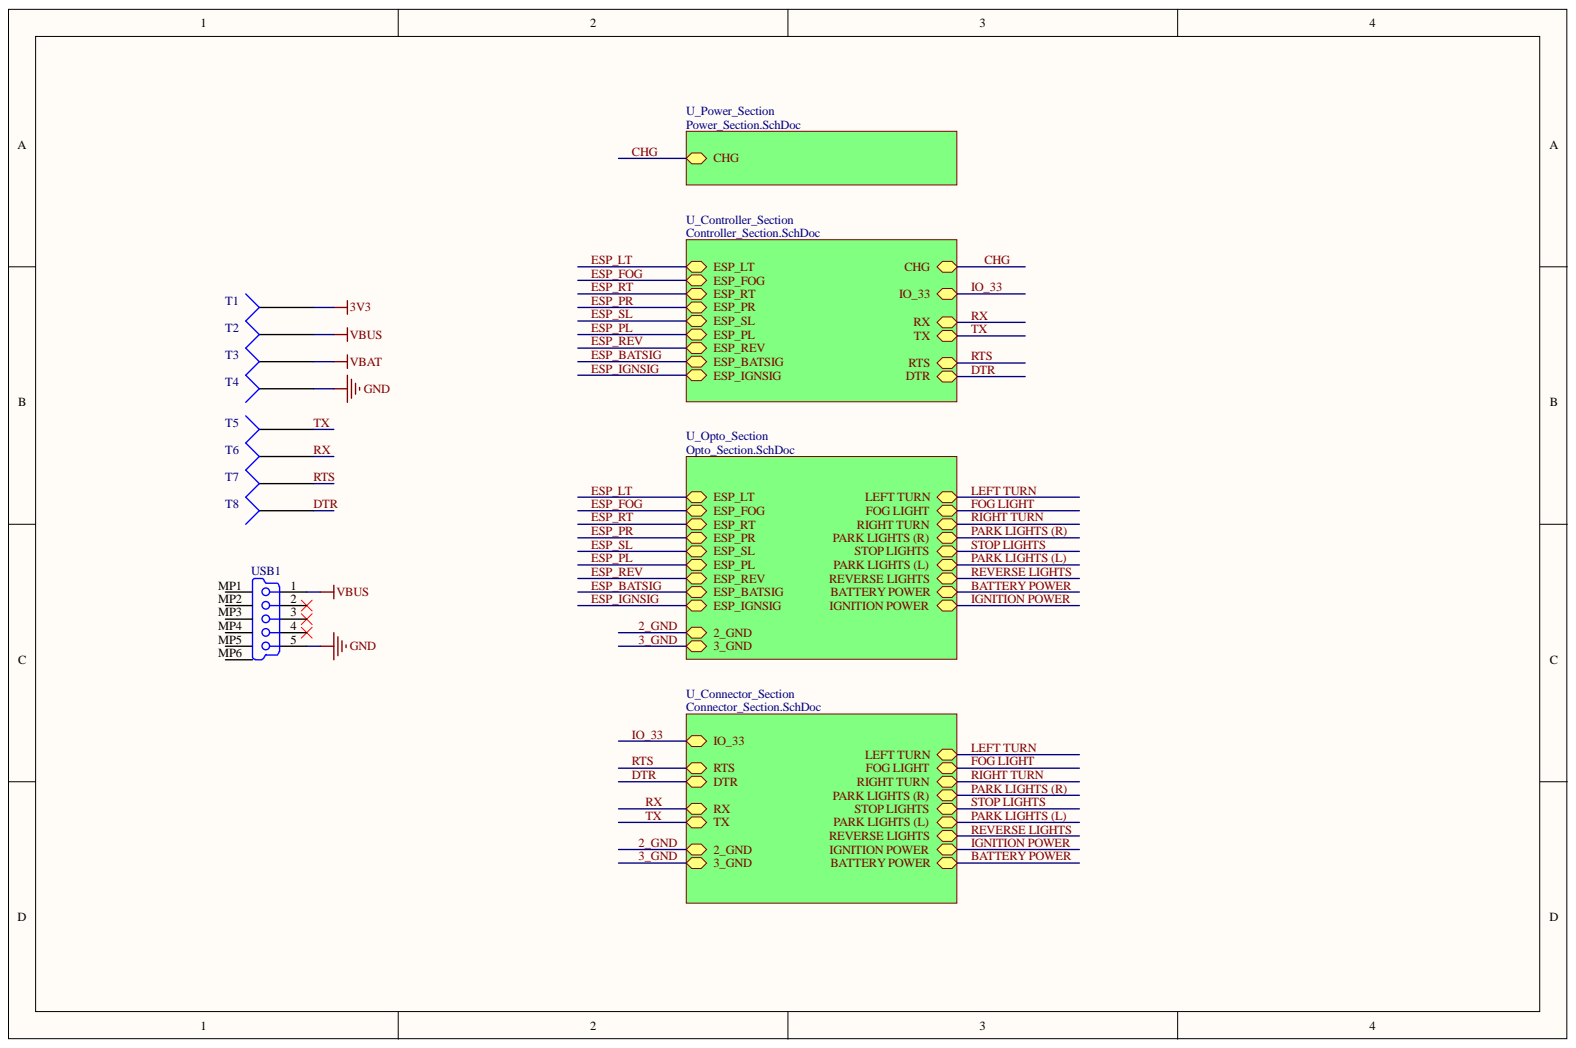
[picture p16: page 1]

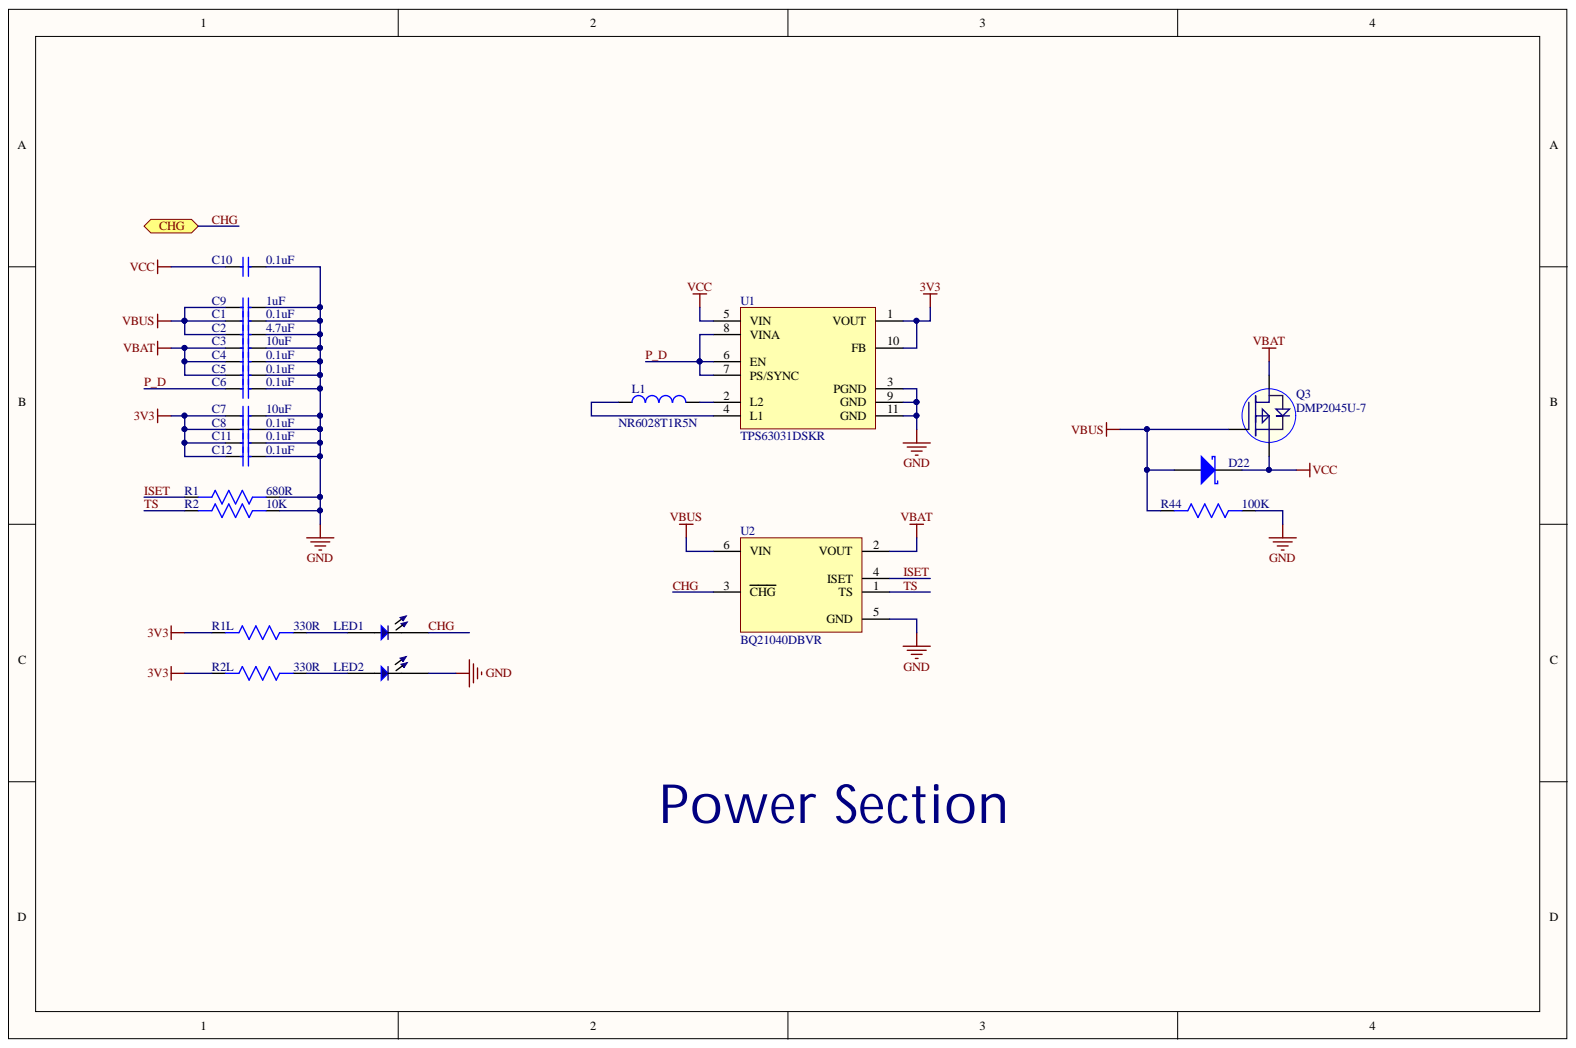
[picture p17: page 2]

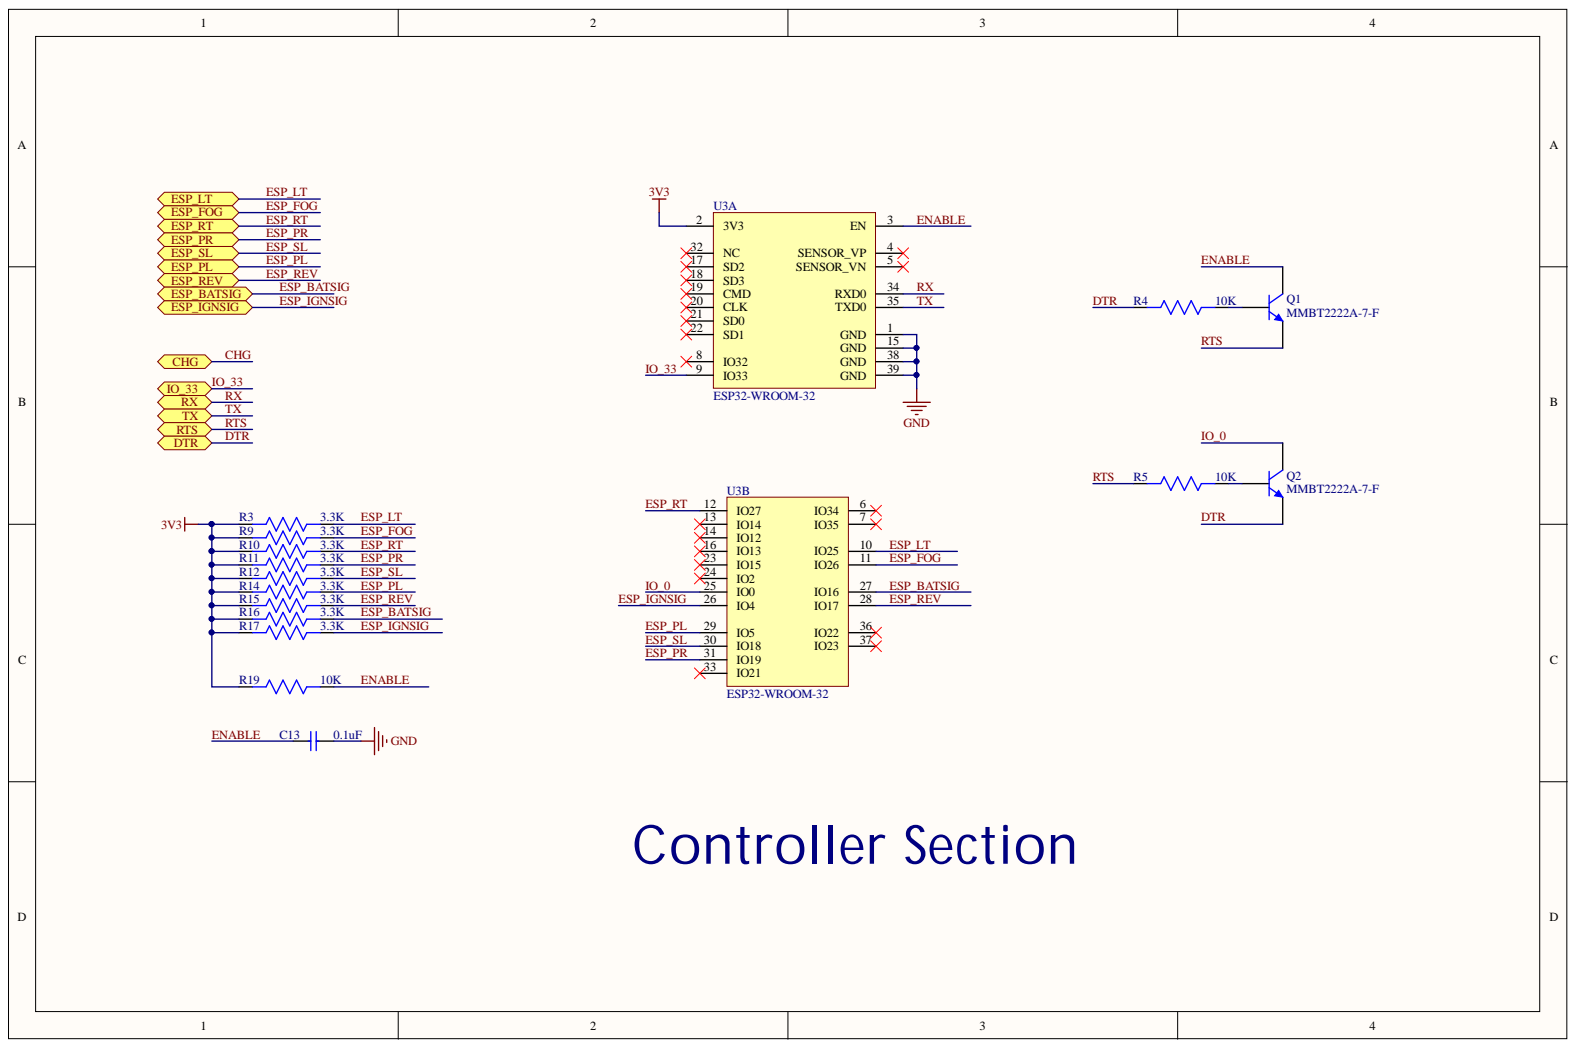
[picture p18: page 3]

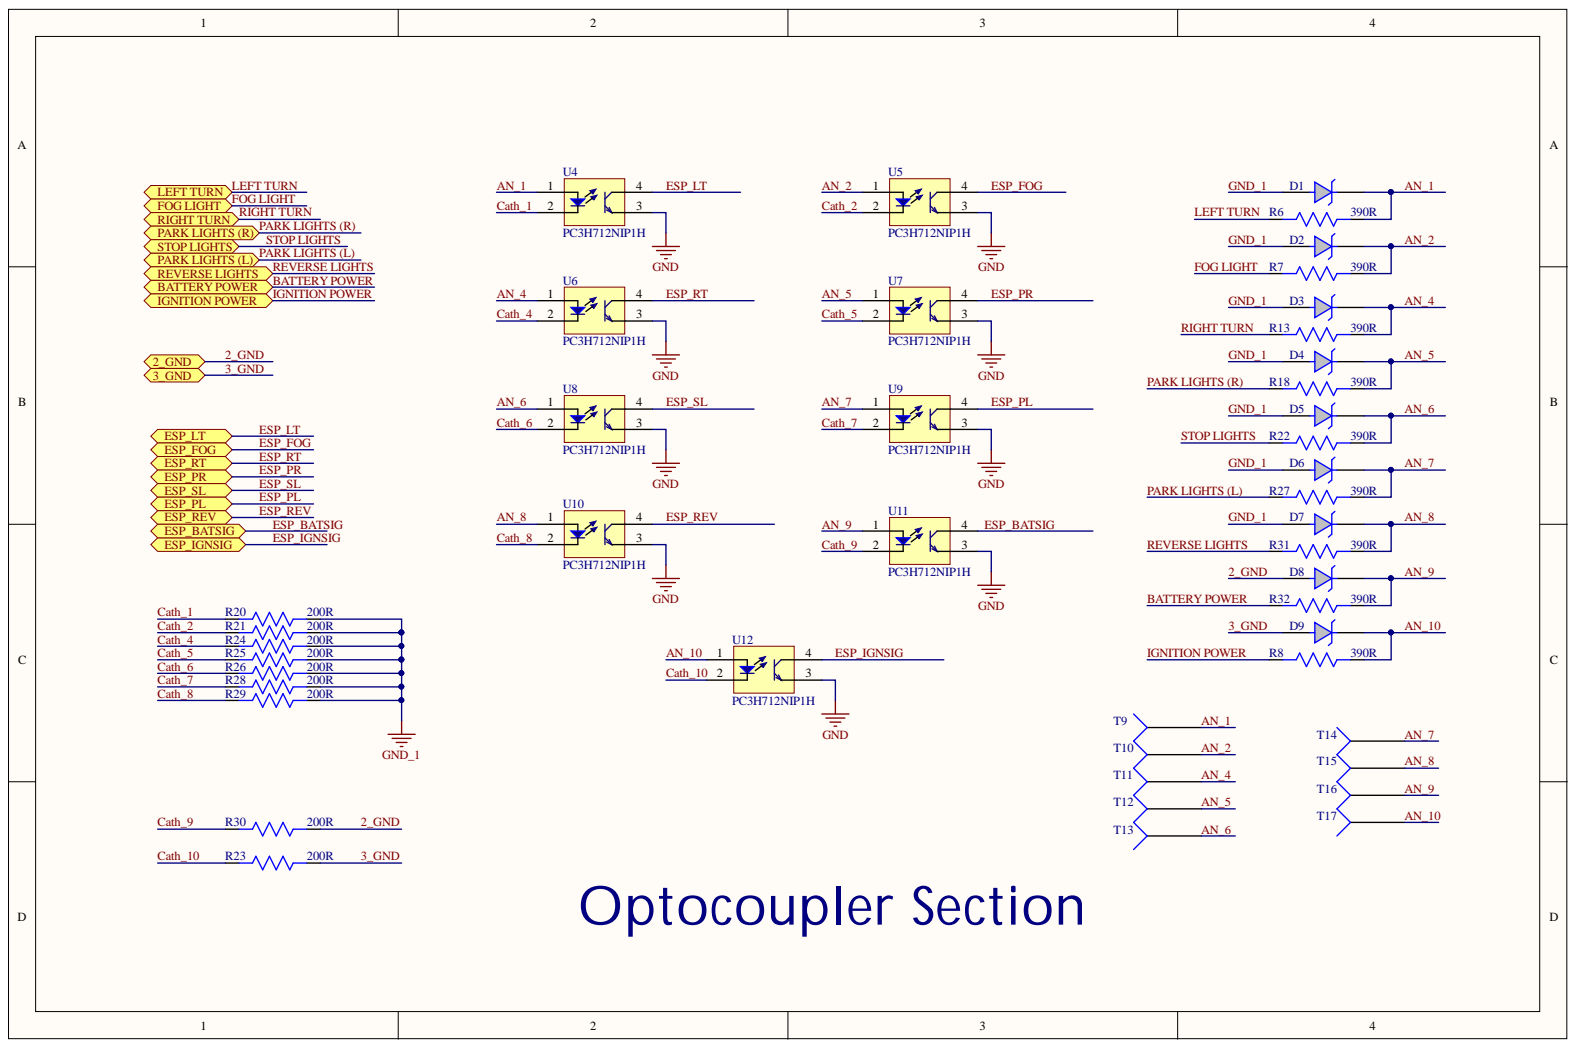
[picture p19: page 4]

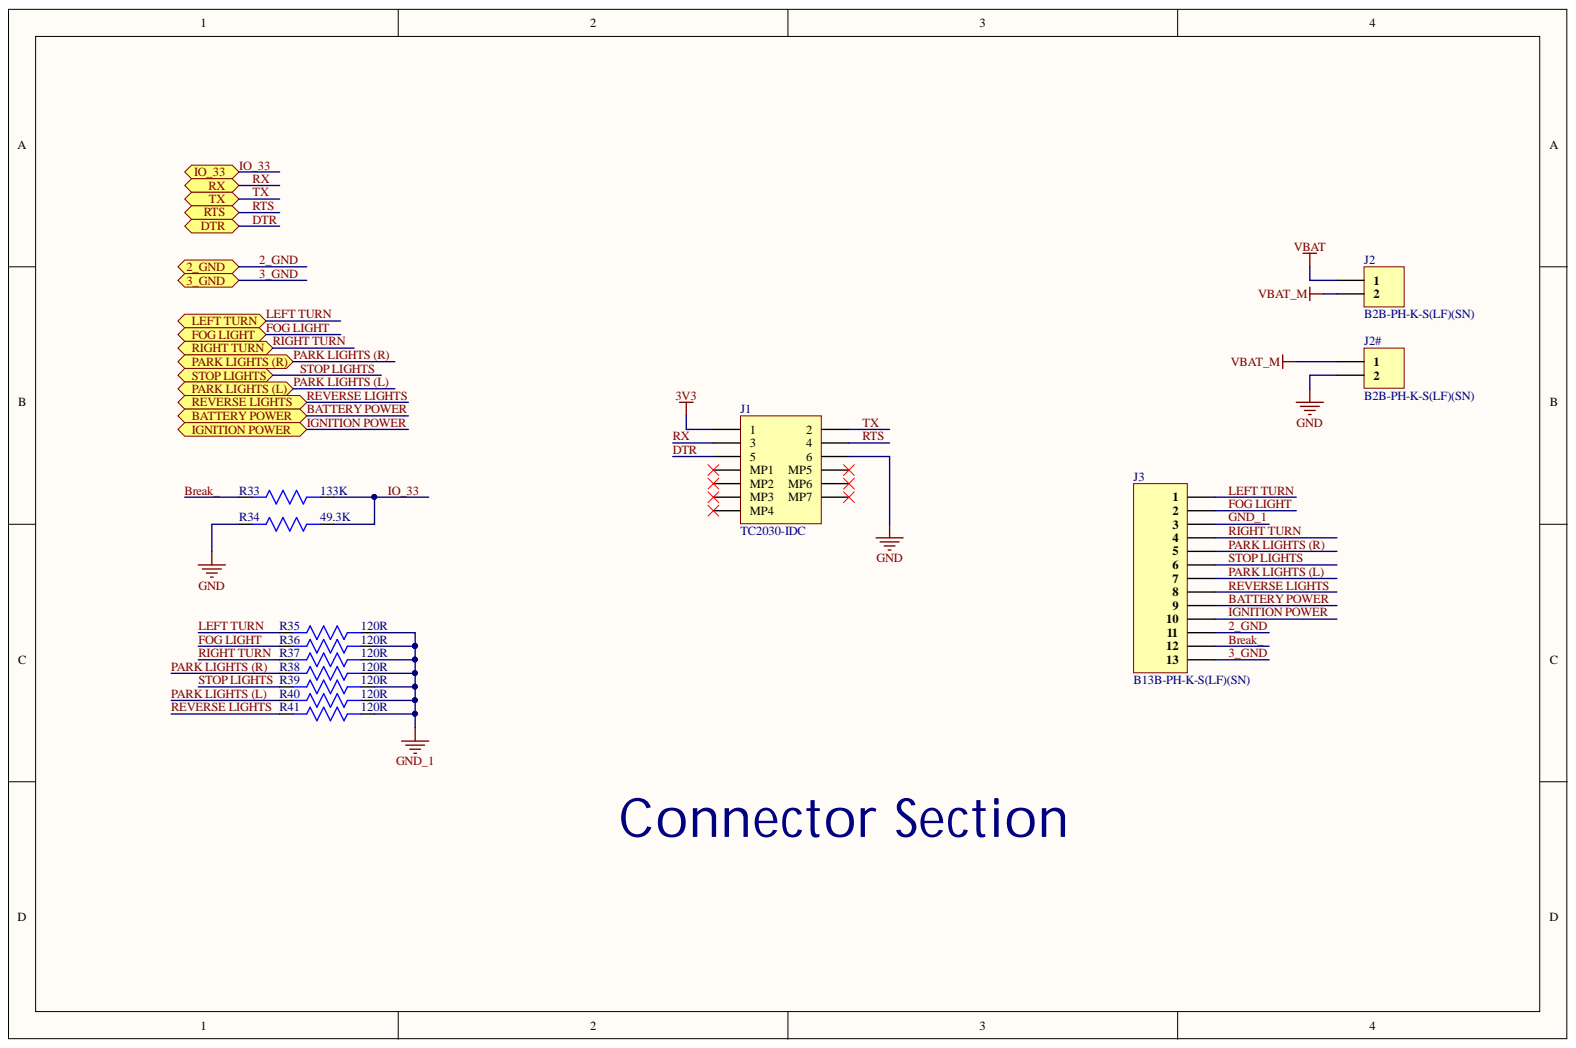
[picture p20: page 5]

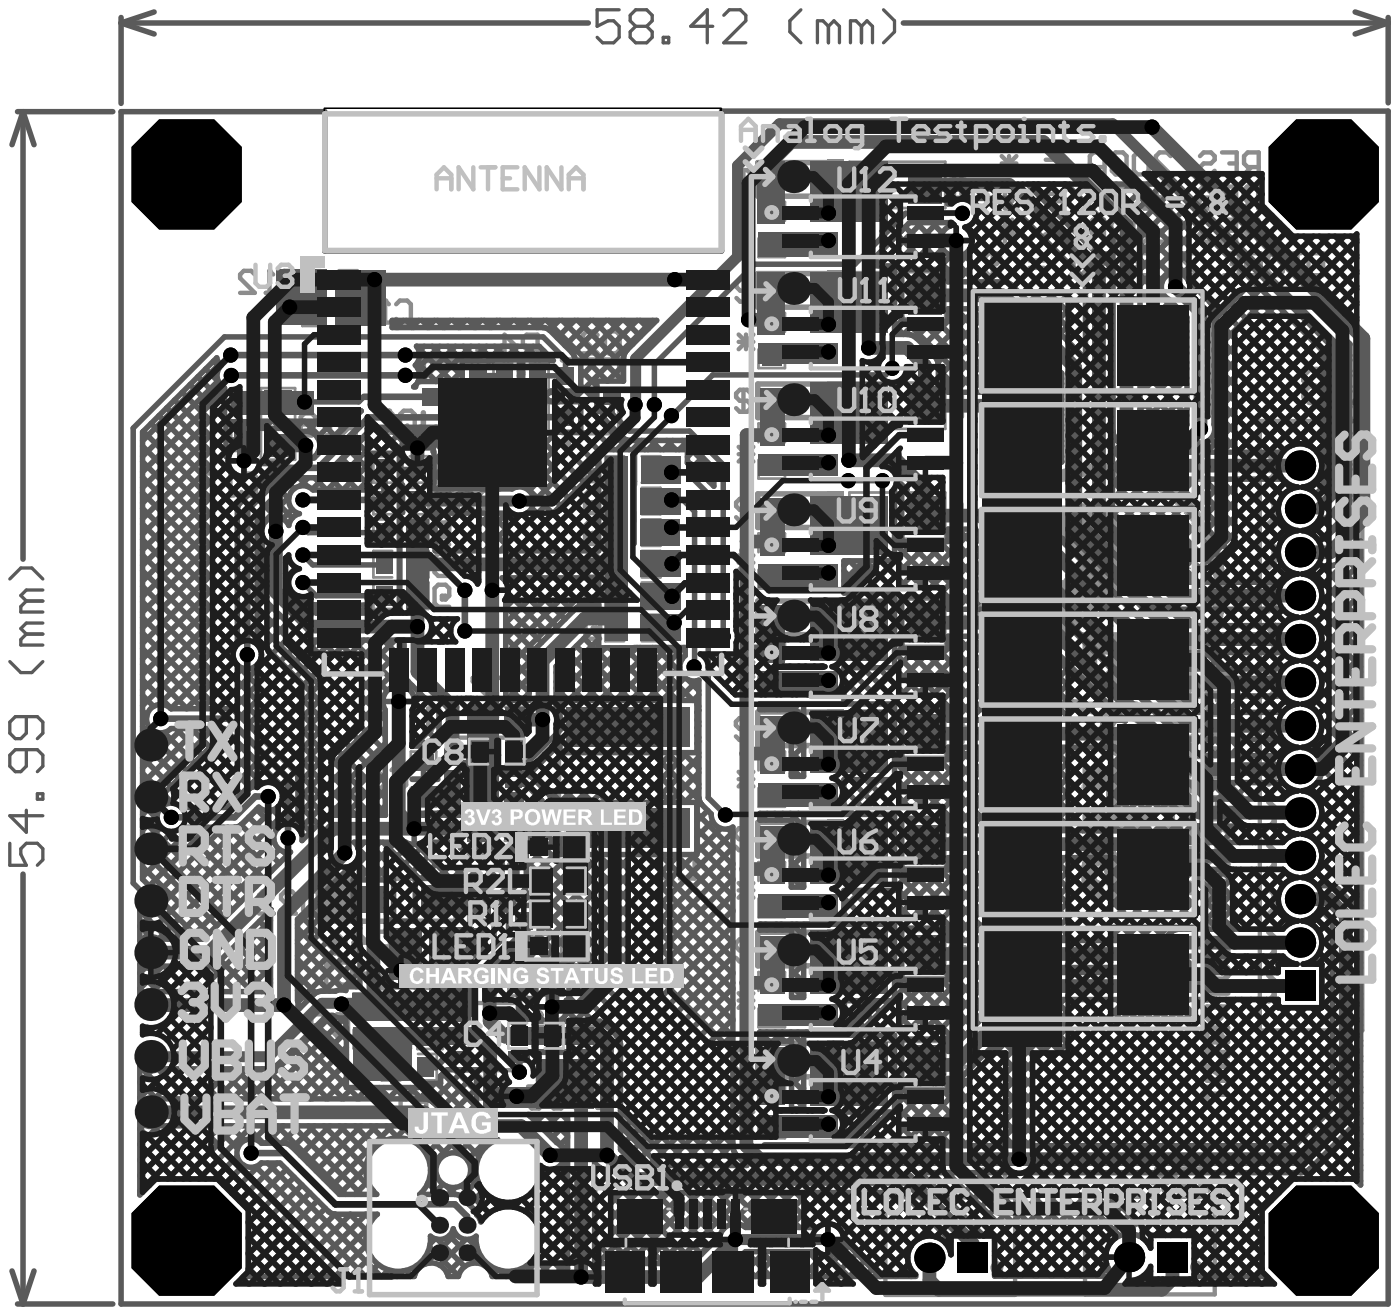
[picture p21: page 6]

# Board S
