eSpark-Backup/fredmeiring-trailersockettester/Hardware-Designing/Deliverables/Schematics/Fred_Old (Schematics).pdf

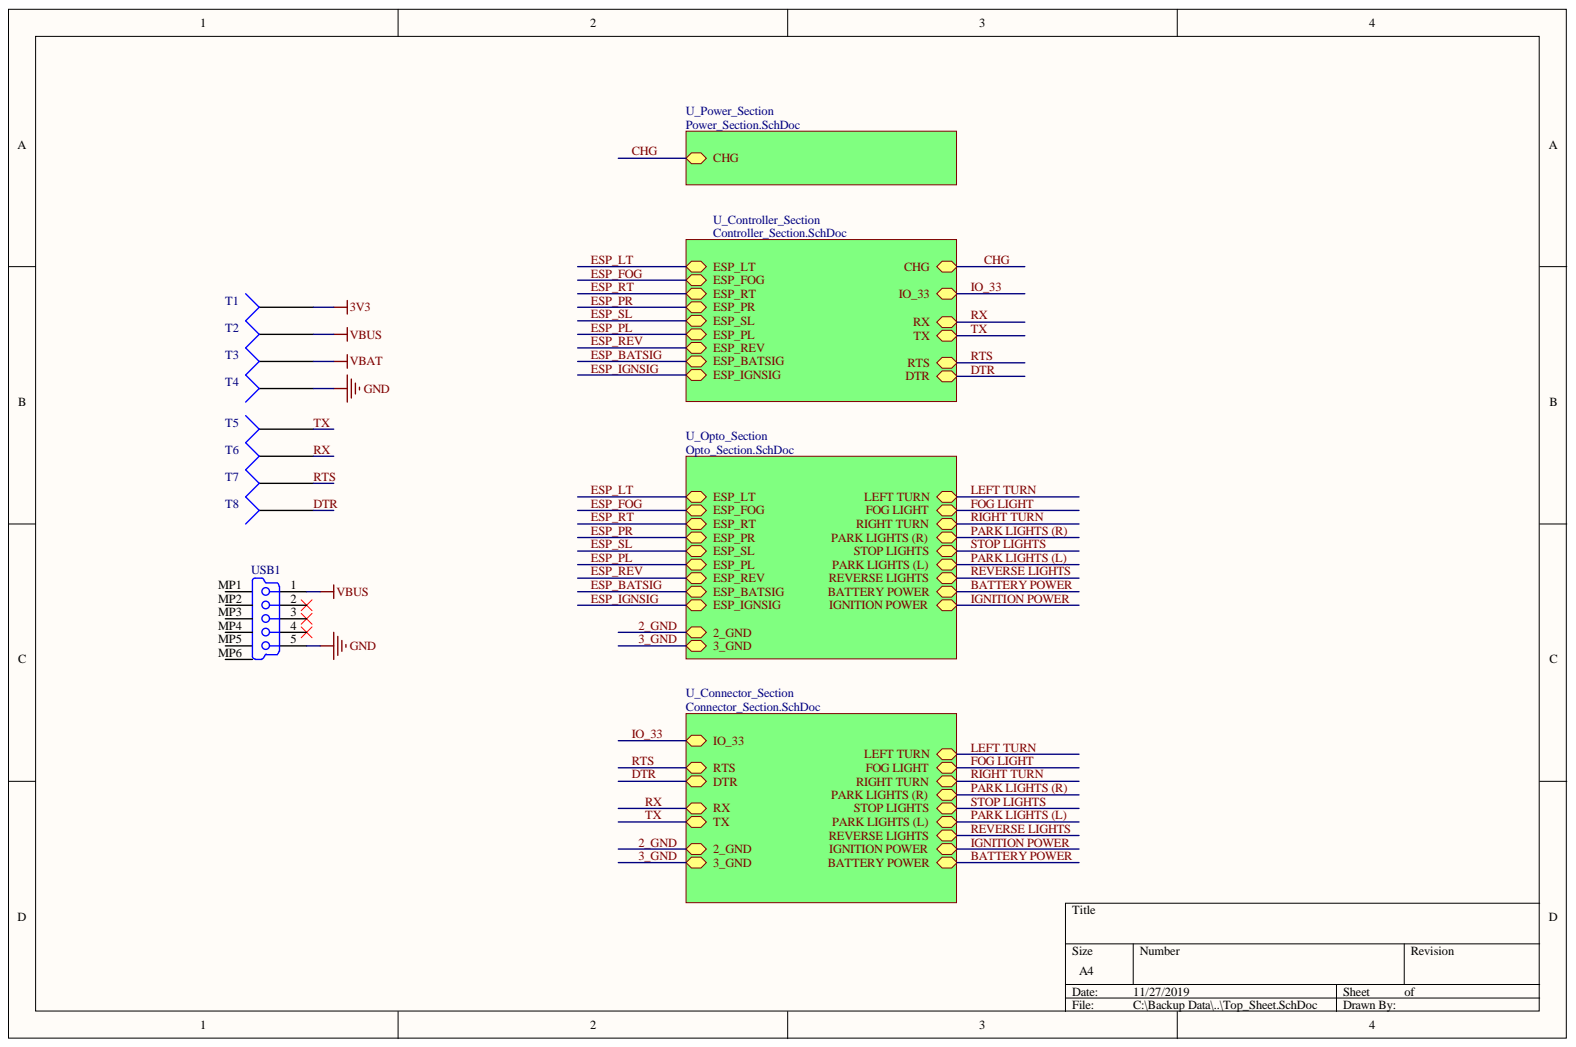
[picture p27: page 1]

Numbe r | R evision

: 11/27/2019 | She et of
File : C:\B a ckup D ata\. .\Top_She et. S chDoc | D r a wn By:

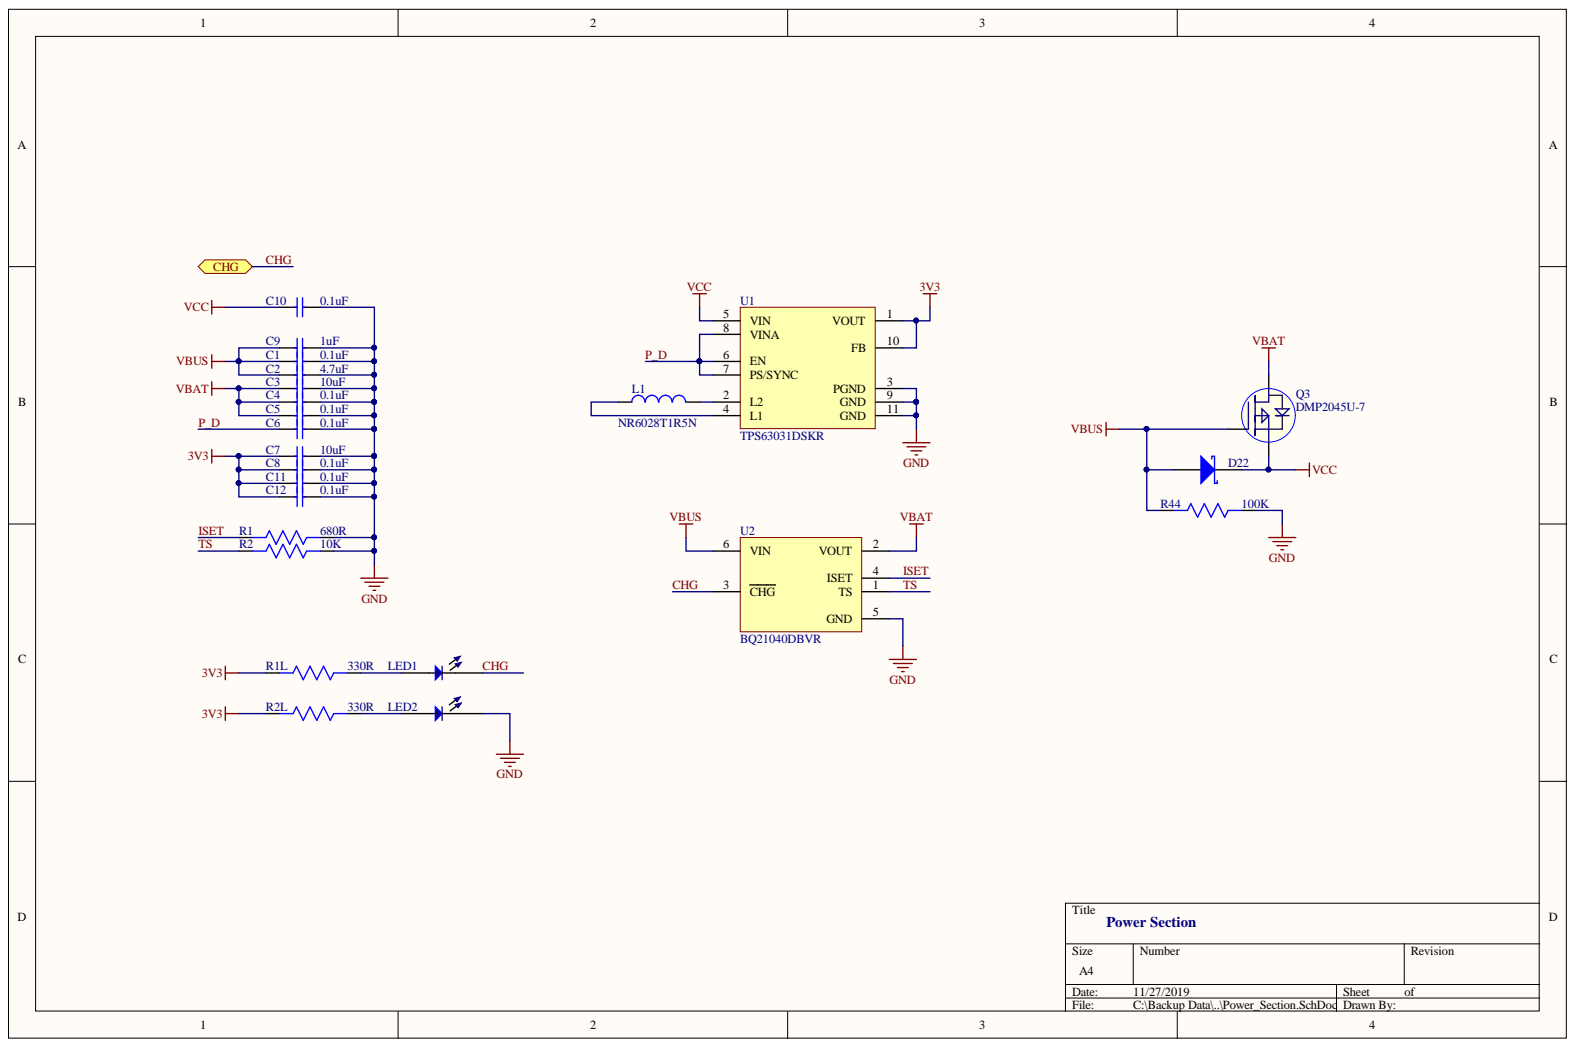
[picture p28: page 2]

Numbe r | R evision

: 11/27/2019 | She et of
File : C:\B a ckup D ata\. .\Pow e r_S e ction. S chDoc | D r a wn By:

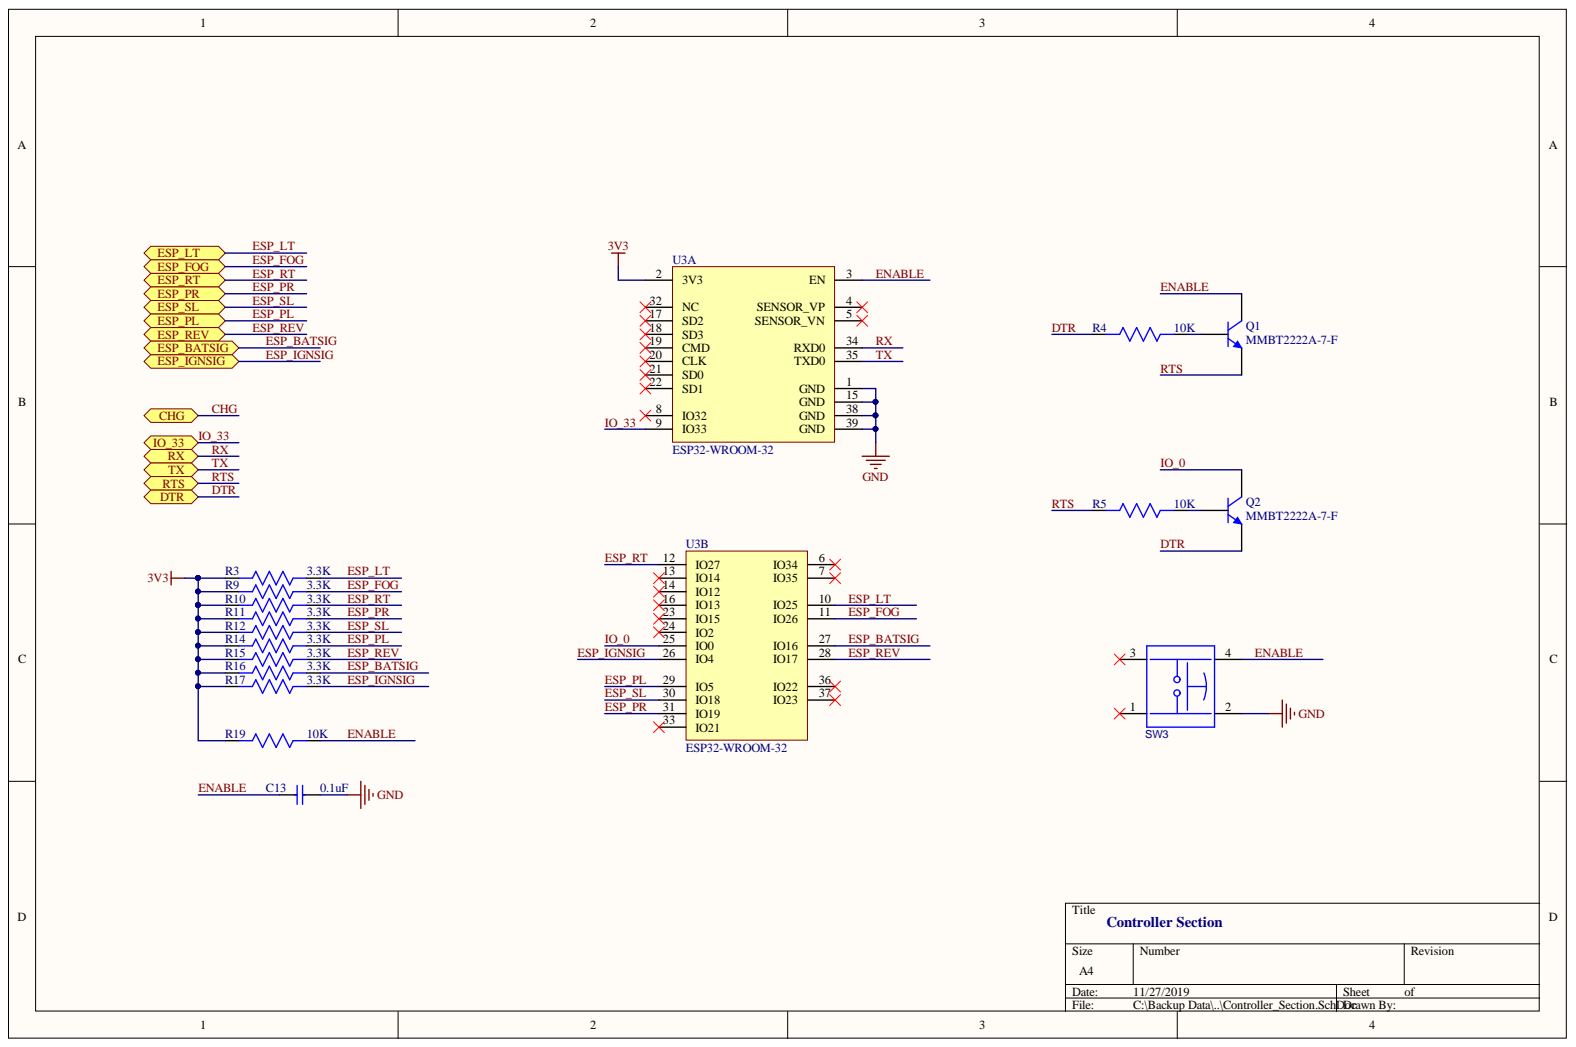
[picture p29: page 3]

Numbe r | R evision

: 11/27/2019 | She et of
File : C:\B a ckup D ata\. .\Controlle r_S e ction. S chDDocra | wn By:

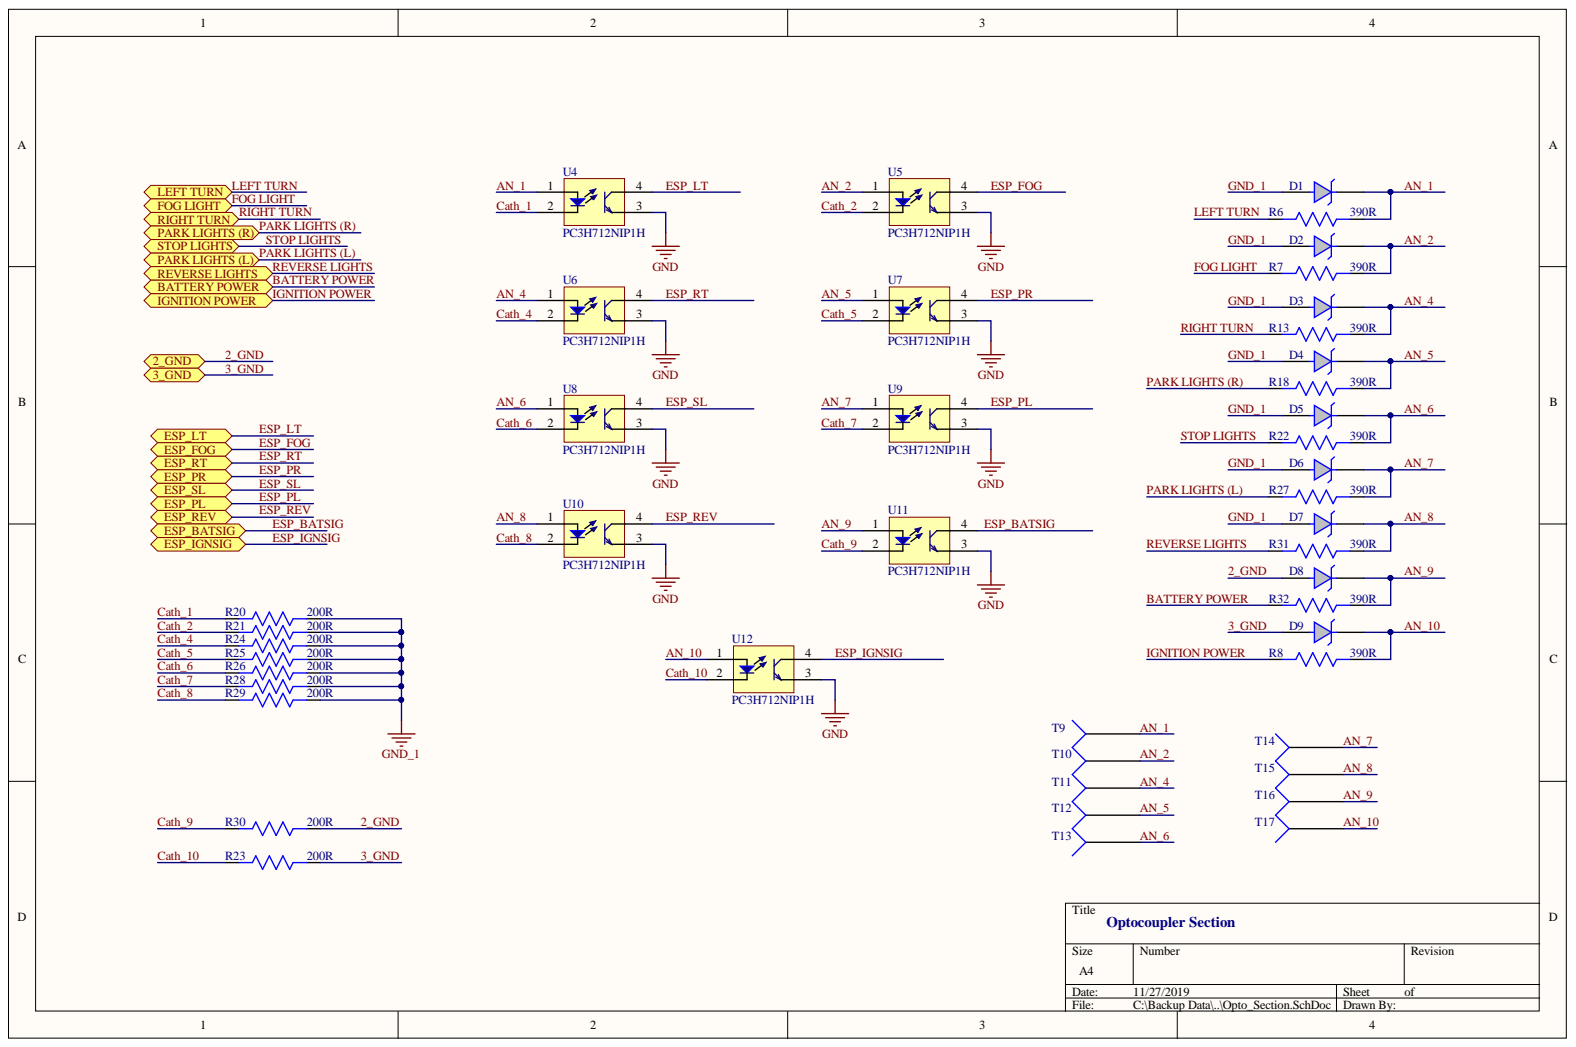
[picture p30: page 4]

Numbe r | R evision

: 11/27/2019 | She et of
File : C:\B a ckup D ata\. .\Opto_S e ction. S chDoc | D r a wn By:

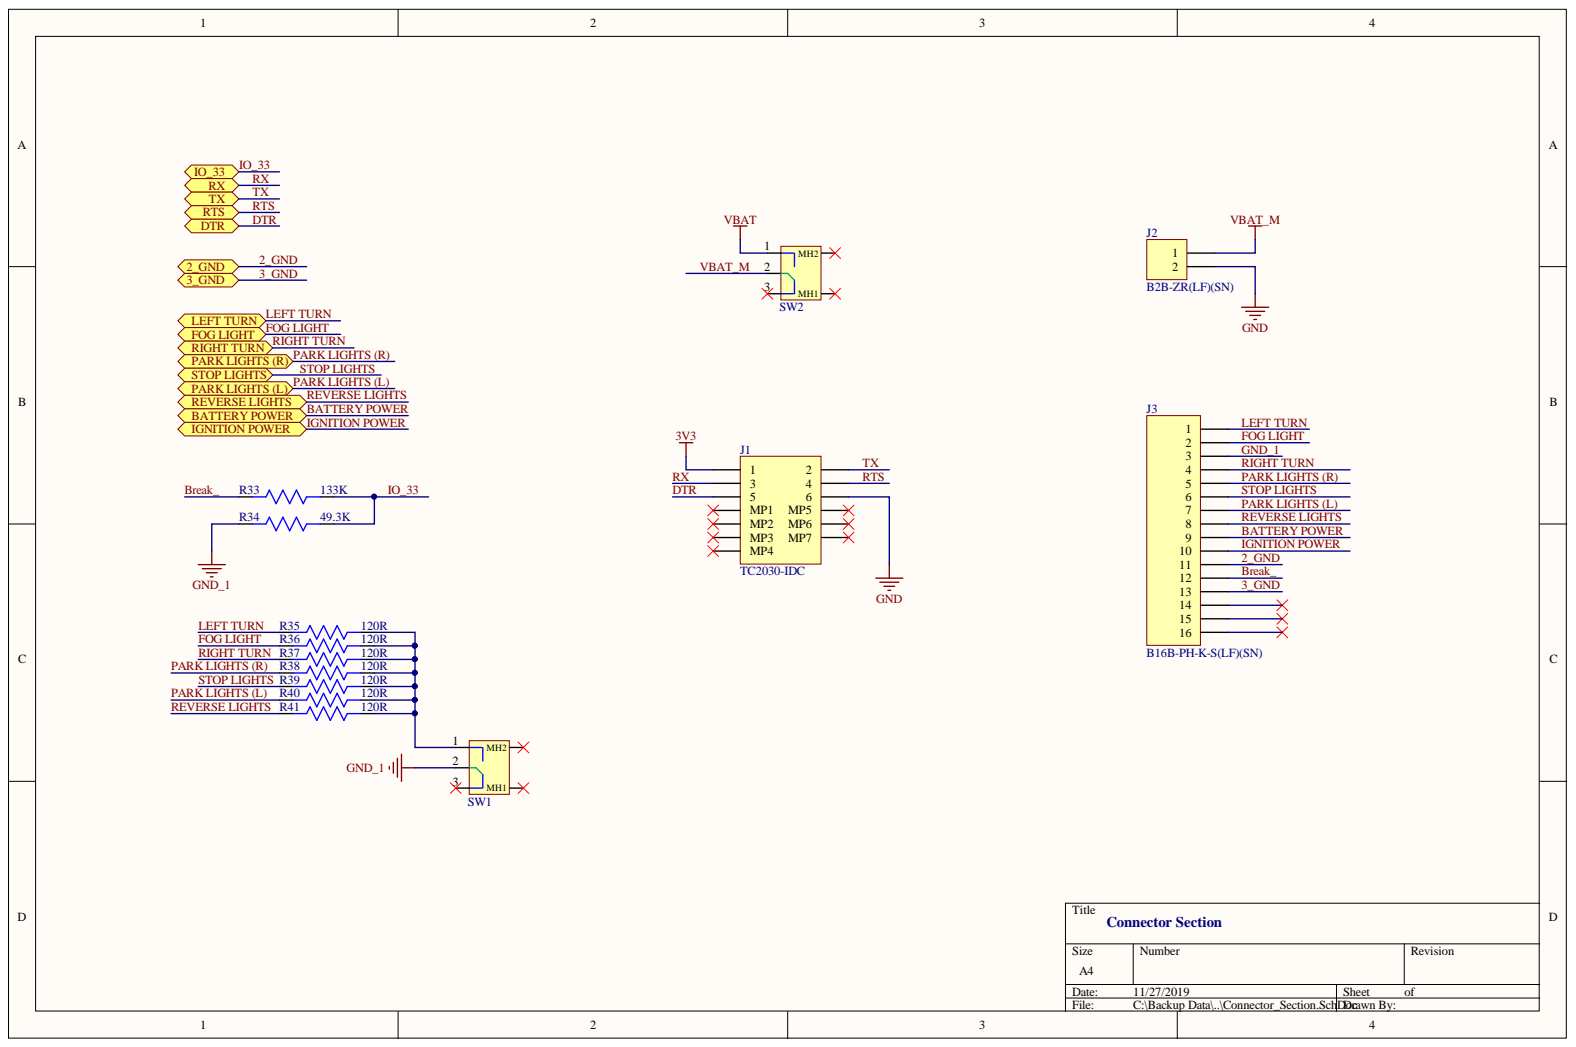
[picture p31: page 5]

Numbe r | R evision

: 11/27/2019 | She et of
File : C:\B a ckup D ata\. .\Conne ctor_S e ction. S chDDocra | wn By:
