eSpark-Backup/fredmeiring-trailersockettester/(list of files, drawings)

Other design files:
Hardware-Designing/Design-Files/Connector_Section.SchDoc
Hardware-Designing/Design-Files/Controller_Section.SchDoc
Hardware-Designing/Design-Files/Fred_ New.PcbDoc
Hardware-Designing/Design-Files/FRED_MIERING.PrjPCB
Hardware-Designing/Design-Files/Opto_Section.SchDoc
Hardware-Designing/Design-Files/Power_Section.SchDoc
Hardware-Designing/Design-Files/Top_Sheet.SchDoc
Hardware-Designing/Library-Files/Fred,.SchLib
Hardware-Designing/Library-Files/Fred..PcbLib
