eSpark-Backup/fredmeiring-trailersockettester/(commit log)

2023-07-21 #2 Schematics Improved
    Schematics Improved
2023-07-24 #2 Circuit Upgraded
    Schematics Upgraded to latest version
2023-07-26 #2 Schematic Updated
